awtismlover/photon-line-follower/README.md

<h1 align="center"> Photon1.0: Turbo Line Follower Robot</h1>

<div align="center">

   

<i>Loved the project? Please consider giving a Star ⭐️</i>

</div>

## ⭐️For now work in progres⭐️

> ### **Photon will be fast and light line follower robot with track optimalization.**

## Custom ESC

> ### **For the drive system Photon will use BLDC motors which will be driven by ESCs based on Escape32**

<div align="center">
  
</div>

## Hardware

- uC - STM32G474RET6
- drivers - Custom ESCs
- sensor - 12x KTIR0711S
- battery - 300mAh 3s LiPo
- wheels - Kyosho Mini Z
- motors - 1404 BLDC
- Bluetooth - HC-04

## Credits
> Photon uses custom BLDC based on neoxic's ESCape32 project
> https://github.com/neoxic/ESCape32
