awtismlover/photon-line-follower/photon_bldc/hardware/pcb/G071_ESC_rev2/ESC_PCB/Fortior Tech FD6288Q driver library/FD6288Q.step

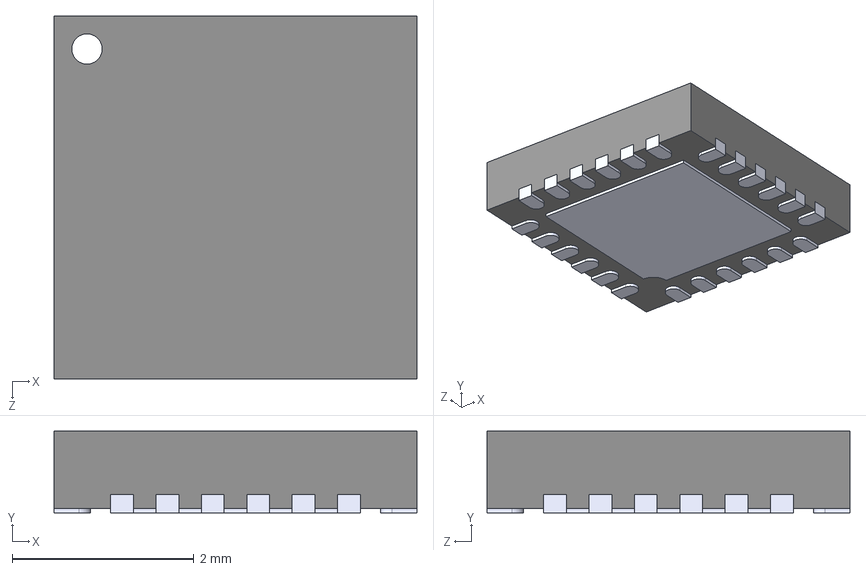
[picture p1: CAD file, 2025-04-08]
photon_bldc/hardware/pcb/G071_ESC_rev2/ESC_PCB/Fortior Tech FD6288Q driver library/FD6288Q.step
4.00 x 0.9 x 4.00 mm
