awtismlover/photon-line-follower/photon_bldc/hardware/pcb/G071_ESC_rev2/ESC_PCB/MOSFET 3D Model/User Library-TDSON-8-1.STEP

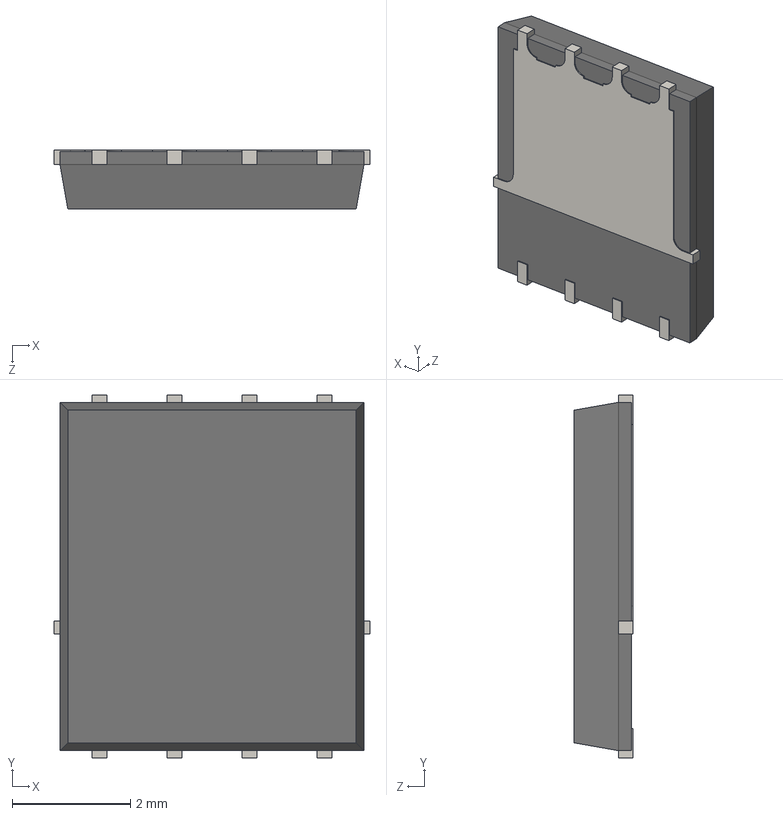
[picture p2: CAD file, 2025-04-15]
photon_bldc/hardware/pcb/G071_ESC_rev2/ESC_PCB/MOSFET 3D Model/User Library-TDSON-8-1.STEP
5.35 x 6.15 x 1.00 mm
