awtismlover/photon-line-follower/photon_bldc/hardware/pcb/G071_ESC_rev2/ESC_PCB/MOSFET_lib/PDFN3333 (DFN8 3.3x3.3).STEP

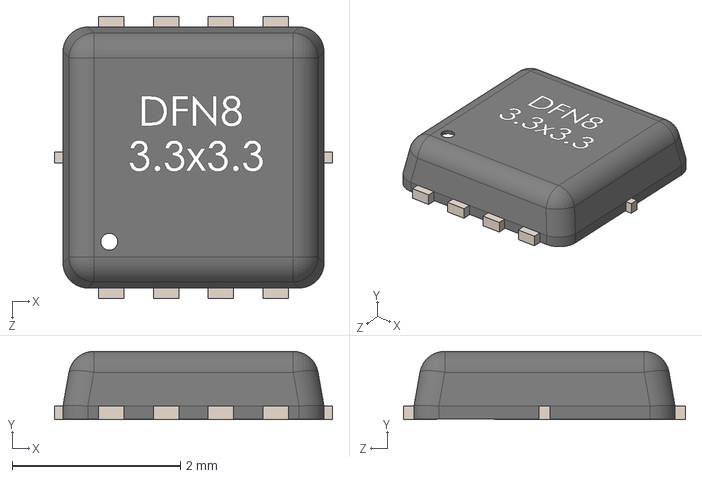
[picture p3: CAD file, 2025-07-21]
photon_bldc/hardware/pcb/G071_ESC_rev2/ESC_PCB/MOSFET_lib/PDFN3333 (DFN8 3.3x3.3).STEP
3.30 x 0.81 x 3.35 mm
