awtismlover/photon-line-follower/photon_bldc/hardware/pcb/G071_ESC_rev2/ESC_PCB/TPHR8504PL_L1Q.step

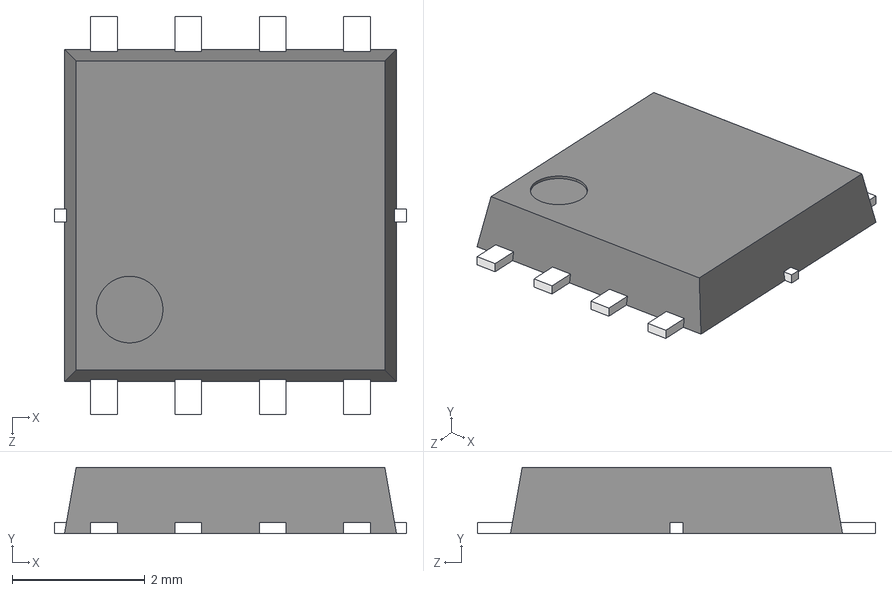
[picture p4: CAD file, 2025-07-26]
photon_bldc/hardware/pcb/G071_ESC_rev2/ESC_PCB/TPHR8504PL_L1Q.step
5.30 x 1.00 x 6.00 mm
