awtismlover/photon-line-follower/photon_bldc/hardware/pcb/IMU_ICM42688/ICM42688/ICM-42688-P/ICM-42688-P.step

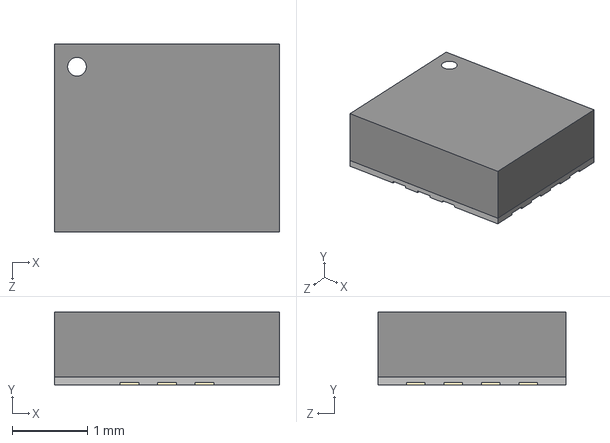
[picture p5: CAD file, 2025-04-16]
photon_bldc/hardware/pcb/IMU_ICM42688/ICM42688/ICM-42688-P/ICM-42688-P.step
3.00 x 0.97 x 2.50 mm
