awtismlover/photon-line-follower/photon_bldc/hardware/pcb/one_sided_main_board/HC-04 v2.step

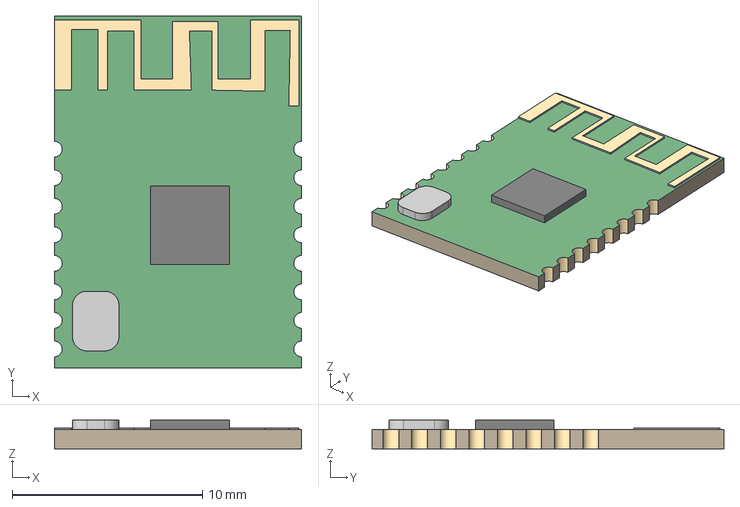
[picture p6: CAD file, 2025-03-23]
photon_bldc/hardware/pcb/one_sided_main_board/HC-04 v2.step
13.0 x 18.5 x 1.50 mm
