awtismlover/photon-line-follower/photon_bldc/hardware/pcb/G071_ESC_rev2/ESC_PCB/UFQFPN28-4x4-05.step

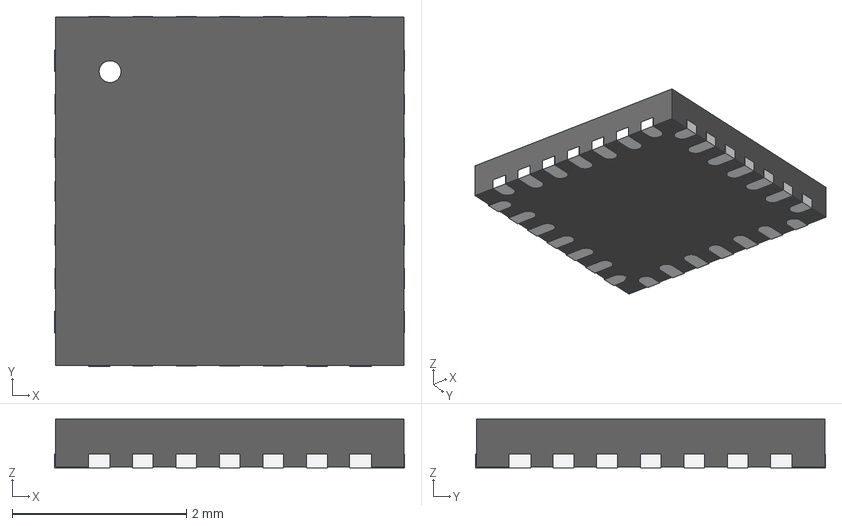
[picture p8: CAD file, 2025-04-20]
photon_bldc/hardware/pcb/G071_ESC_rev2/ESC_PCB/UFQFPN28-4x4-05.step
4.03 x 4.02 x 0.56 mm
Pin001
CPin001
CPin002
Pin002
Pin003
Pin004
Pin005
CPin003
CPin004
CPin005
CPin006
CPin007
CPin008
