awtismlover/photon-line-follower/photon_bldc/hardware/pcb/one_sided_main_board/JST_SH_3D_models/SM05B-SRSS-TB.STEP

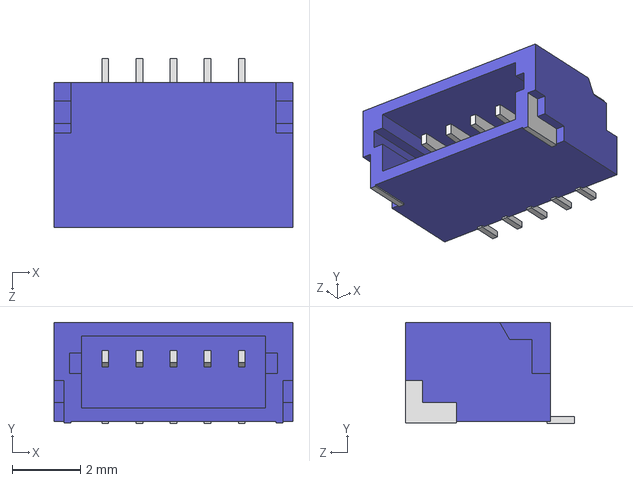
[picture p9: CAD file, 2025-05-06]
photon_bldc/hardware/pcb/one_sided_main_board/JST_SH_3D_models/SM05B-SRSS-TB.STEP
7.00 x 2.96 x 4.95 mm
