awtismlover/photon-line-follower/photon_bldc/hardware/pcb/one_sided_main_board/JST_SH_3D_models/SM02B-SRSS-TB.STEP

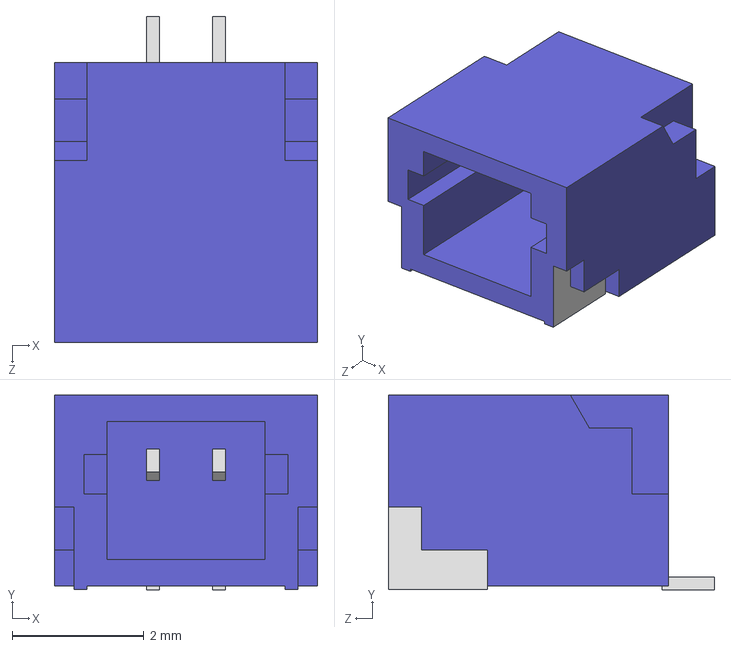
[picture p10: CAD file, 2025-05-06]
photon_bldc/hardware/pcb/one_sided_main_board/JST_SH_3D_models/SM02B-SRSS-TB.STEP
4.00 x 2.96 x 4.95 mm
