awtismlover/photon-line-follower/photon_bldc/hardware/pcb/one_sided_main_board/JST_SH_3D_models/SM07B-SRSS-TB v1.step

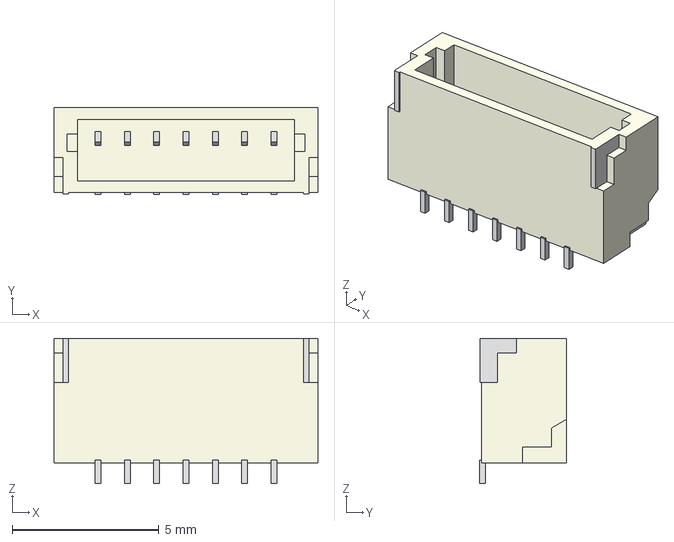
[picture p12: CAD file, 2025-05-06]
photon_bldc/hardware/pcb/one_sided_main_board/JST_SH_3D_models/SM07B-SRSS-TB v1.step
9.00 x 2.96 x 4.95 mm
