awtismlover/photon-line-follower/(list of files, cad)

Other CAD files:
photon_bldc/hardware/pcb/one_sided_main_board/JST_SH_3D_models/SM04B-SRSS-TB v1.step
photon_bldc/hardware/pcb/one_sided_main_board/JST_SH_3D_models/SM05B-SRSS-TB v1.step
photon_bldc/hardware/pcb/one_sided_main_board/JST_SH_3D_models/SM06B-SRSS-TB.STEP
photon_bldc/hardware/pcb/one_sided_main_board/JST_SH_3D_models/SM02B-SRSS-TB v1.step
photon_bldc/hardware/pcb/one_sided_main_board/JST_SH_3D_models/SM07B-SRSS-TB.STEP
