awtismlover/photon-line-follower/(list of files, drawings)

Other design files:
photon_bldc/hardware/pcb/prototype(v0)/hc-04/PCB_NEW_PCB_2024-11-19.json
