awtismlover/photon-line-follower/photon_bldc/hardware/pcb/Encoder_KTH_7812/KTH7812/KTH7812.kicad_pcb

## KiCad design photon_bldc/hardware/pcb/Encoder_KTH_7812/KTH7812/KTH7812.kicad_pcb (2025-09-22)

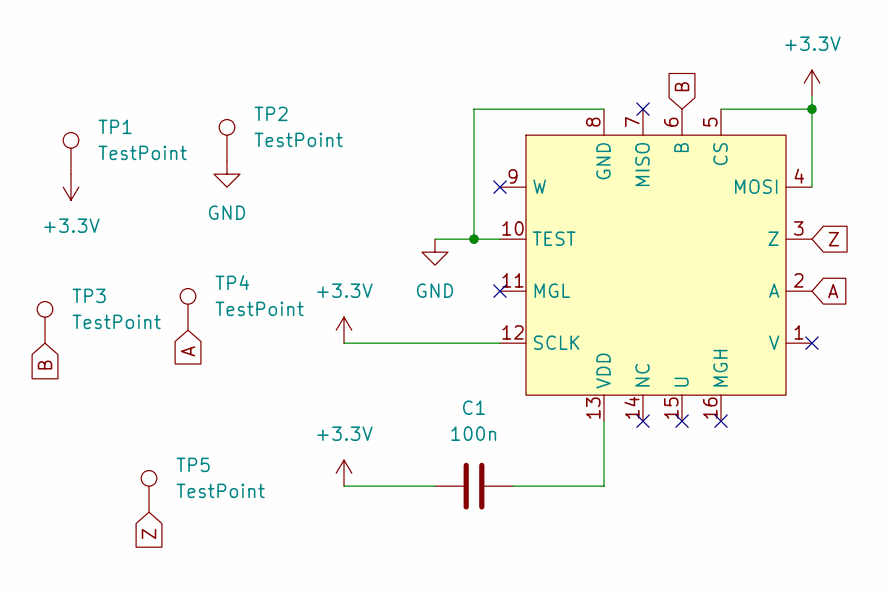
[picture p13: schematic KTH7812.kicad_sch]

Parts:
C1: 100n; C_0402_1005Metric
TP1, TP2, TP3, TP4, TP5: TestPoint; TestPoint_Pad_1.0x1.0mm
U1: KTH7812

Connections:
+3.3V: C1.1, TP1.1, U1.4 (MOSI), U1.5 (CS), U1.12 (SCLK)
A: TP4.1, U1.2 (A)
B: TP3.1, U1.6 (B)
GND: TP2.1, U1.8 (GND), U1.10 (TEST)
unnamed: C1.2, U1.13 (VDD)
Z: TP5.1, U1.3 (Z)

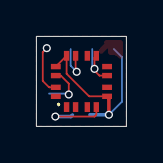
[picture p14: board KTH7812.kicad_pcb from above]

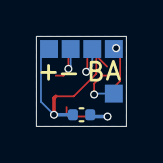
[picture p15: board KTH7812.kicad_pcb from below]

Board: 2 copper layers, 5.0 x 5.0 mm, 7 parts (6 on the bottom side), 6 nets.
