awtismlover/photon-line-follower/photon_bldc/hardware/pcb/IMU_ICM42688/ICM42688/ICM42688.kicad_pcb

## KiCad design photon_bldc/hardware/pcb/IMU_ICM42688/ICM42688/ICM42688.kicad_pcb (2025-09-16)

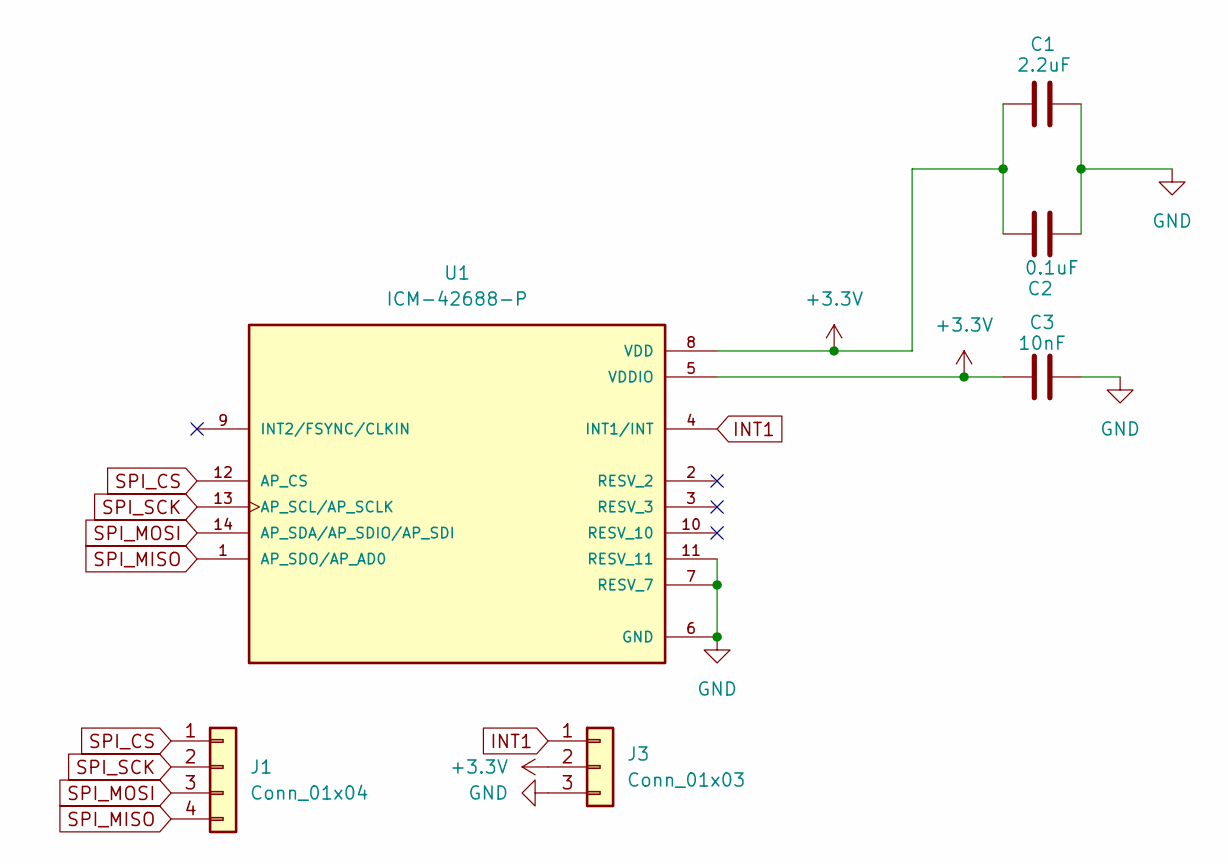
[picture p16: schematic ICM42688.kicad_sch]

Parts:
C1: 2.2uF; C_0402_1005Metric_Pad0.74x0.62mm_HandSolder
C2: 0.1uF; C_0402_1005Metric_Pad0.74x0.62mm_HandSolder
C3: 10nF; C_0402_1005Metric_Pad0.74x0.62mm_HandSolder
J1: Conn_01x04; 4_cable_pad
J3: Conn_01x03; 3_cable_pad
U1: ICM-42688-P; PQFN50P300X250X97-14N; PARTREV 1.2

Connections:
+3.3V: C1.2, C2.1, C3.1, J3.2, U1.5 (VDDIO), U1.8 (VDD)
GND: C1.1, C2.2, C3.2, J3.3, U1.6 (GND), U1.7 (RESV_7), U1.11 (RESV_11)
INT1: J3.1, U1.4 (INT1/INT)
SPI_CS: J1.1, U1.12 (AP_CS)
SPI_MISO: J1.4, U1.1 (AP_SDO/AP_AD0)
SPI_MOSI: J1.3, U1.14 (AP_SDA/AP_SDIO/AP_SDI)
SPI_SCK: J1.2, U1.13 (AP_SCL/AP_SCLK)

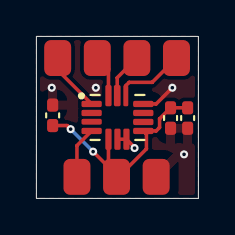
[picture p17: board ICM42688.kicad_pcb from above]

Board: 2 copper layers, 9.0 x 9.0 mm, 6 parts (0 on the bottom side), 7 nets.
