awtismlover/photon-line-follower/photon_bldc/hardware/pcb/G071_ESC_rev2/ESC_PCB/ESC_PCB.kicad_pcb

## KiCad design photon_bldc/hardware/pcb/G071_ESC_rev2/ESC_PCB/ESC_PCB.kicad_pcb (2025-07-27)

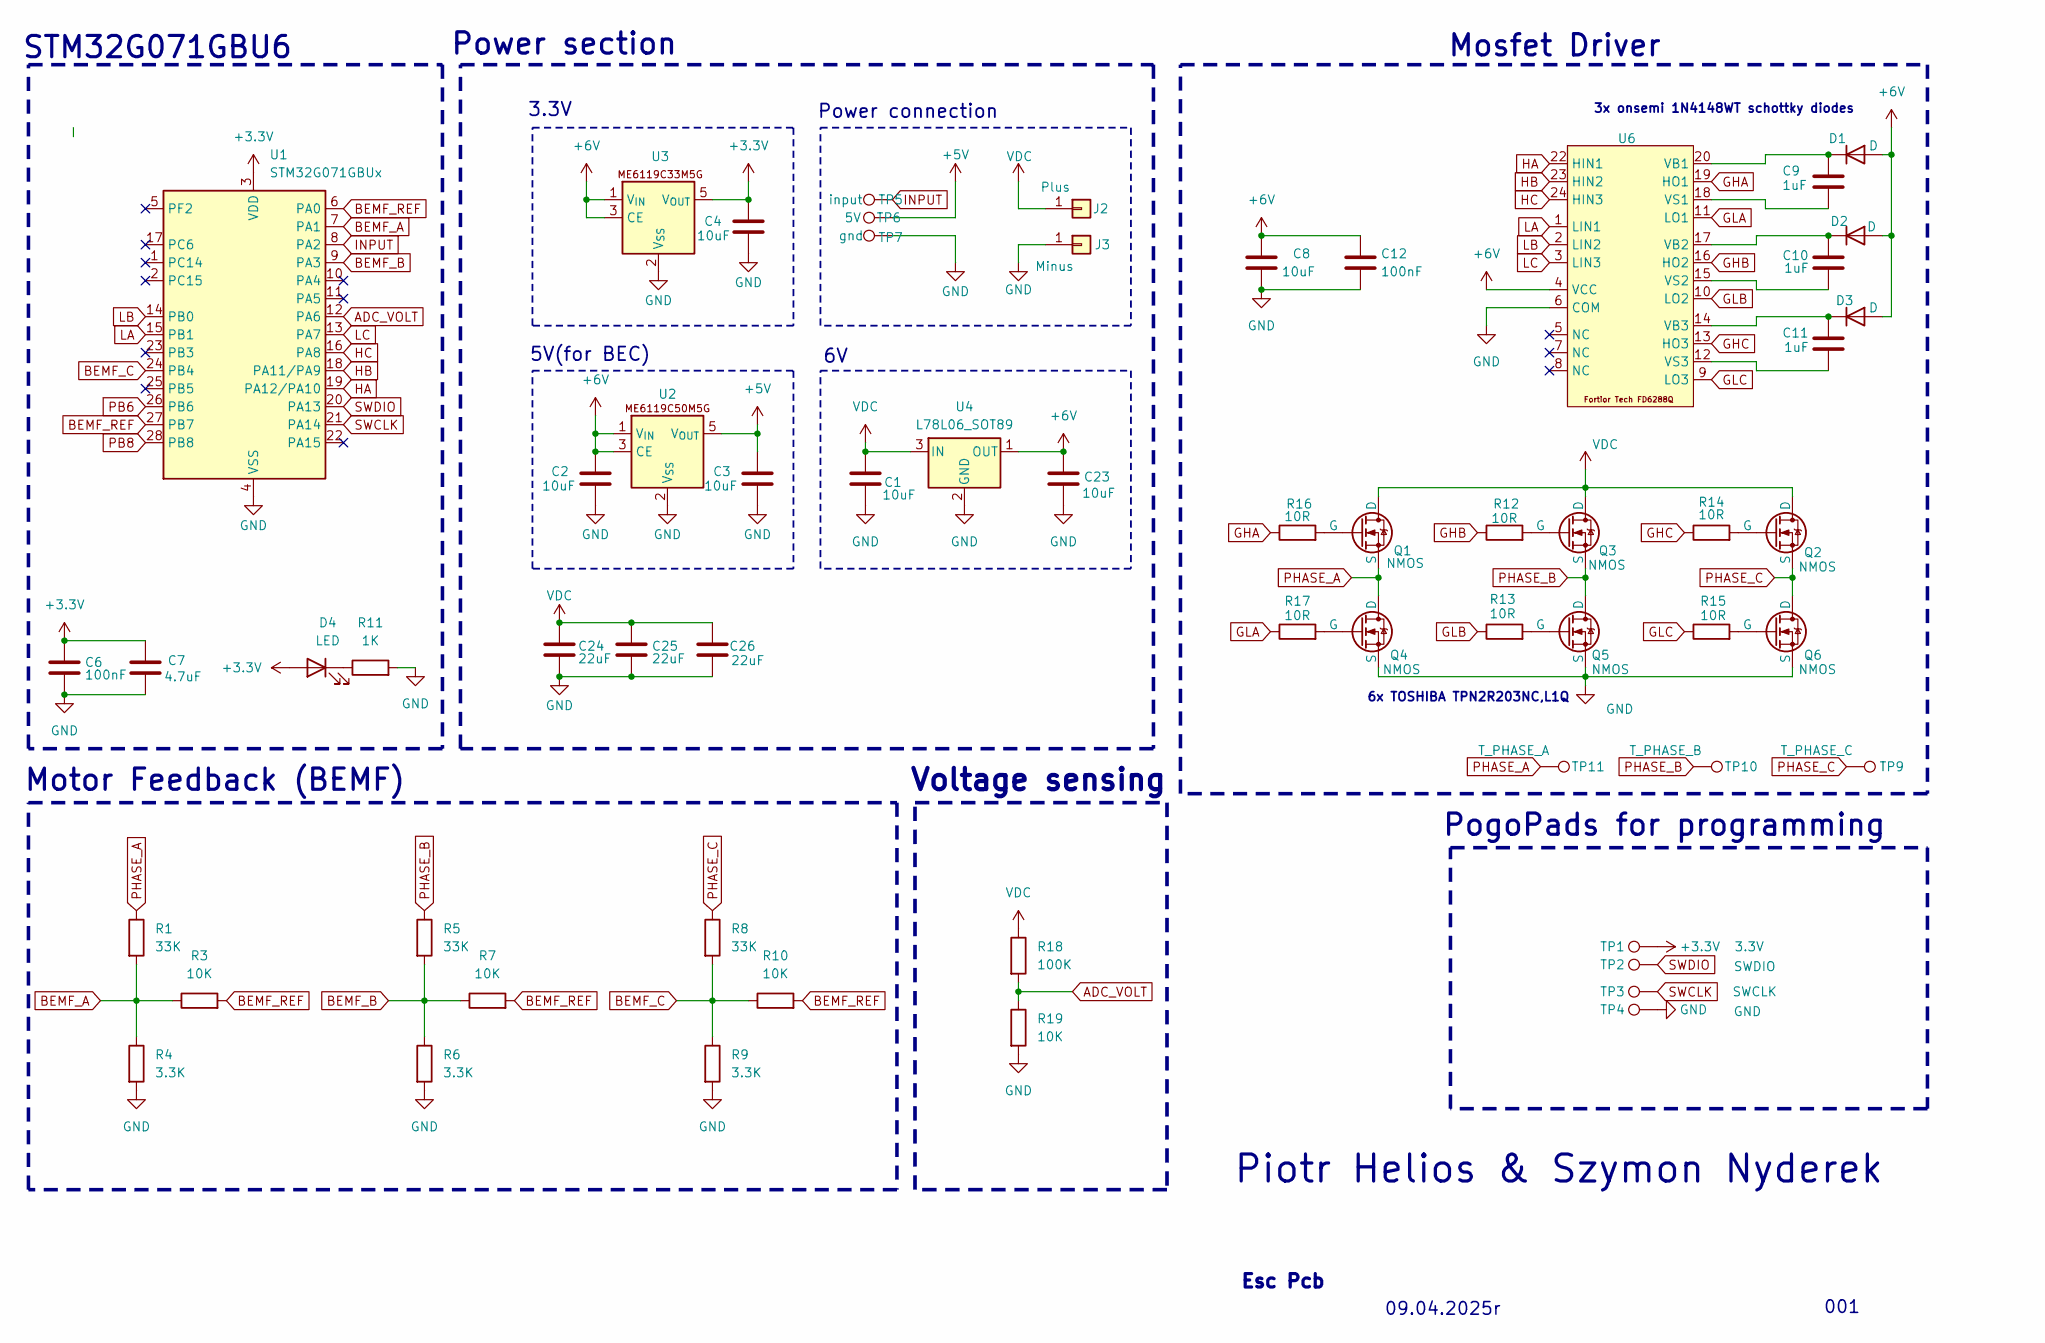
[picture p18: schematic ESC_PCB.kicad_sch]

Parts:
C1, C2, C3, C4: 10uF; C_0402_1005Metric_Pad0.74x0.62mm_HandSolder
C6, C12: 100nF; C_0402_1005Metric_Pad0.74x0.62mm_HandSolder
C7: 4.7uF; C_0402_1005Metric_Pad0.74x0.62mm_HandSolder
C8, C23: 10uF; C_0603_1608Metric_Pad1.08x0.95mm_HandSolder
C9, C10, C11: 1uF; C_0402_1005Metric_Pad0.74x0.62mm_HandSolder
C24, C25, C26: 22uF; C_0805_2012Metric_Pad1.18x1.45mm_HandSolder
D1, D2, D3: D; D_SOD-523
D4: LED; LED_0603_1608Metric_Pad1.05x0.95mm_HandSolder
J2: Plus; PowerPad
J3: Minus; PowerPad
Q1, Q2, Q3, Q4, Q5, Q6: NMOS; TRANS_TPHR8504PL_L1Q
R1, R5, R8: 33K; R_0402_1005Metric_Pad0.72x0.64mm_HandSolder
R3, R7, R10, R19: 10K; R_0402_1005Metric_Pad0.72x0.64mm_HandSolder
R4, R6, R9: 3.3K; R_0402_1005Metric_Pad0.72x0.64mm_HandSolder
R11: 1K; R_0402_1005Metric_Pad0.72x0.64mm_HandSolder
R12, R13, R14, R15, R16, R17: 10R; R_0402_1005Metric_Pad0.72x0.64mm_HandSolder
R18: 100K; R_0402_1005Metric_Pad0.72x0.64mm_HandSolder
TP1: 3.3V; TestPoint_Pad_D1.0mm
TP2: SWDIO; TestPoint_Pad_D1.0mm
TP3: SWCLK; TestPoint_Pad_D1.0mm
TP4: GND; TestPoint_Pad_D1.0mm
TP5: input; SolderWirePad_1x01_SMD_1x2mm
TP6: 5V; SolderWirePad_1x01_SMD_1x2mm
TP7: gnd; SolderWirePad_1x01_SMD_1x2mm
TP9: T_PHASE_C; PhasePad
TP10: T_PHASE_B; PhasePad
TP11: T_PHASE_A; PhasePad
U1: STM32G071GBUx; QFN-28_4x4mm_P0.5mm
U2, U3: SOT-23-5
U4: L78L06_SOT89; SOT-89-3
U6: QFN50P400X400X90-25N

Connections:
+3.3V: C4.1, C6.1, C7.1, D4.2 (A), TP1.1, U1.3 (VDD), U3.5 (V_{OUT})
+5V: C3.1, TP6.1, U2.5 (V_{OUT})
+6V: C2.1, C8.1, C12.1, C23.1, D1.2 (A), D2.2 (A), D3.2 (A), U2.1 (V_{IN}), U2.3 (CE), U3.1 (V_{IN}), U3.3 (CE), U4.1 (OUT), U6.4 (VCC)
ADC_VOLT: R18.2, R19.1, U1.12 (PA6)
BEMF_A: R1.2, R3.1, R4.1, U1.7 (PA1)
BEMF_B: R5.2, R6.1, R7.1, U1.9 (PA3)
BEMF_C: R8.2, R9.1, R10.1, U1.24 (PB4)
BEMF_REF: R3.2, R7.2, R10.2, U1.6 (PA0), U1.27 (PB7)
GHA: R16.1, U6.19 (HO1)
GHB: R12.1, U6.16 (HO2)
GHC: R14.1, U6.13 (HO3)
GLA: R17.1, U6.11 (LO1)
GLB: R13.1, U6.10 (LO2)
GLC: R15.1, U6.9 (LO3)
GND: C1.2, C2.2, C3.2, C4.2, C6.2, C7.2, C8.2, C12.2, C23.2, C24.2, C25.2, C26.2, J3.1, Q4.3 (S), Q5.3 (S), Q6.3 (S), R4.2, R6.2, R9.2, R11.2, R19.2, TP4.1, TP7.1, U1.4 (VSS), U2.2 (V_{SS}), U3.2 (V_{SS}), U4.2 (GND), U6.6 (COM); also elsewhere on the board
HA: U1.19 (PA12/PA10), U6.22 (HIN1)
HB: U1.18 (PA11/PA9), U6.23 (HIN2)
HC: U1.16 (PA8), U6.24 (HIN3)
INPUT: TP5.1, U1.8 (PA2)
LA: U1.15 (PB1), U6.1 (LIN1)
LB: U1.14 (PB0), U6.2 (LIN2)
LC: U1.13 (PA7), U6.3 (LIN3)
unnamed: C9.1, D1.1 (K), U6.20 (VB1)
unnamed: C10.1, D2.1 (K), U6.17 (VB2)
unnamed: C11.1, D3.1 (K), U6.14 (VB3)
unnamed: D4.1 (K), R11.1
unnamed: Q1.2 (G), R16.2
unnamed: Q2.2 (G), R14.2
unnamed: Q3.2 (G), R12.2
unnamed: Q4.2 (G), R17.2
unnamed: Q5.2 (G), R13.2
unnamed: Q6.2 (G), R15.2
unnamed: C9.2, U6.18 (VS1)
unnamed: C10.2, U6.15 (VS2)
unnamed: C11.2, U6.12 (VS3)
PB6: U1.26 (PB6)
PB8: U1.28 (PB8)
PHASE_A: Q1.3 (S), Q4.1 (D), R1.1, TP11.1
PHASE_B: Q3.3 (S), Q5.1 (D), R5.1, TP10.1
PHASE_C: Q2.3 (S), Q6.1 (D), R8.1, TP9.1
SWCLK: TP3.1, U1.21 (PA14)
SWDIO: TP2.1, U1.20 (PA13)
VDC: C1.1, C24.1, C25.1, C26.1, J2.1, Q1.1 (D), Q2.1 (D), Q3.1 (D), R18.1, U4.3 (IN); also elsewhere on the board

Notes on the sheet:
Power section
001
3x onsemi 1N4148WT schottky diodes
3.3V
Esc Pcb
5V(for BEC)
Piotr Helios & Szymon Nyderek
Voltage sensing
Motor Feedback (BEMF)
Mosfet Driver
Power connection
STM32G071GBU6
PogoPads for programming
6x TOSHIBA TPN2R203NC,L1Q
09.04.2025r

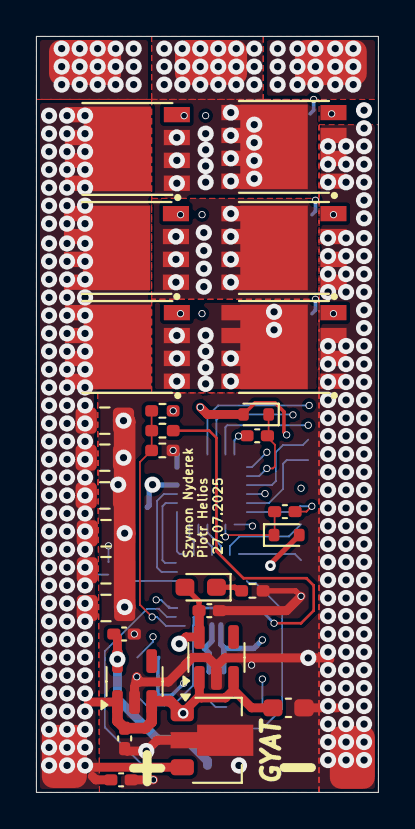
[picture p19: board ESC_PCB.kicad_pcb from above]

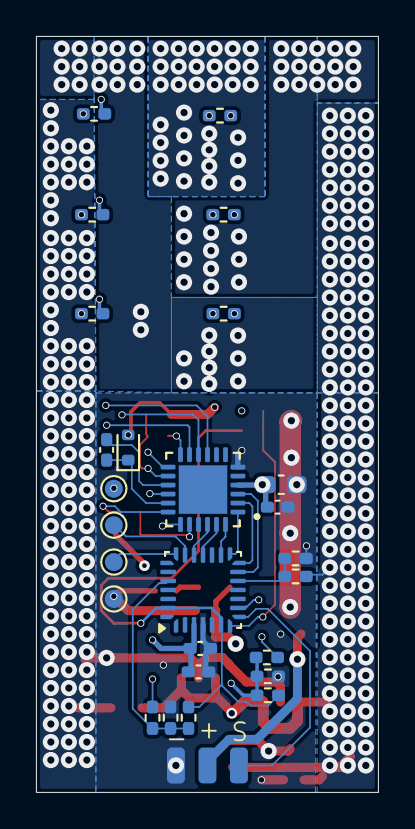
[picture p20: board ESC_PCB.kicad_pcb from below]

Board: 6 copper layers, 19.0 x 42.0 mm, 63 parts (29 on the bottom side), 41 nets.

Other parts of the board:
C24#2, C25#2, C26#2: 22uF; C_0805_2012Metric_Pad1.18x1.45mm_HandSolder

Their connections:
GND: C24#2.2, C25#2.2, C26#2.2; also elsewhere on the board
VDC: C24#2.1, C25#2.1, C26#2.1; also elsewhere on the board
