awtismlover/photon-line-follower/photon_bldc/hardware/pcb/Sensor_Analog/AnalogSensorPCB/AnalogSensorPCB.kicad_pcb

## KiCad design photon_bldc/hardware/pcb/Sensor_Analog/AnalogSensorPCB/AnalogSensorPCB.kicad_pcb (2025-05-13)

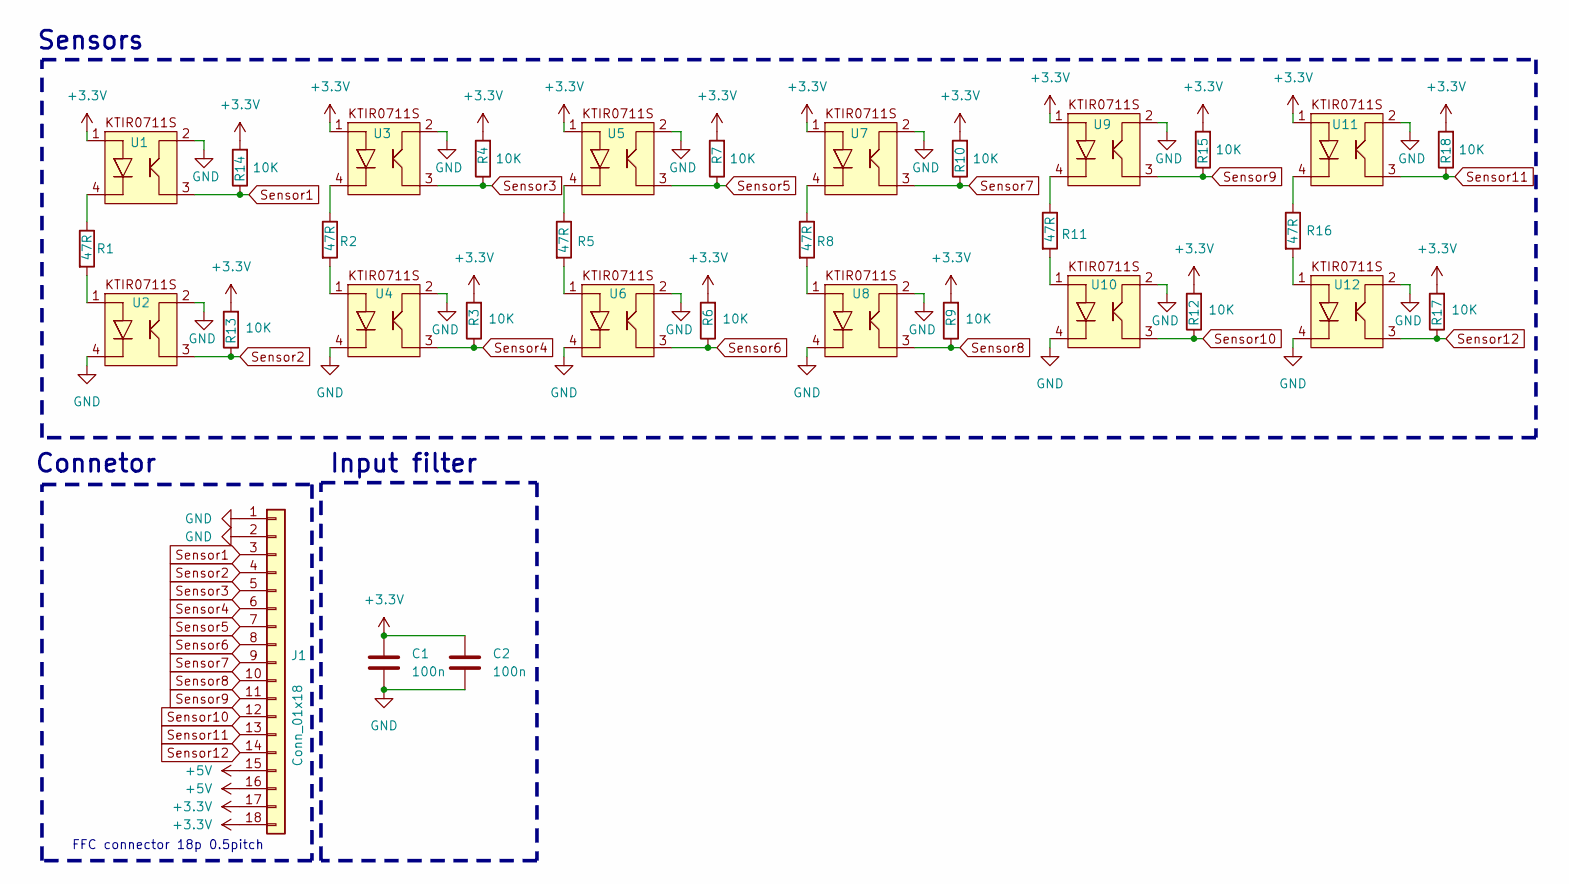
[picture p21: schematic AnalogSensorPCB.kicad_sch]

Parts:
C1, C2: 100n; C_0402_1005Metric_Pad0.74x0.62mm_HandSolder
J1: Conn_01x18; Hirose_FH12-18S-0.5SH_1x18-1MP_P0.50mm_Horizontal
R1, R2, R5, R8, R11, R16: 47R; R_0603_1608Metric_Pad0.98x0.95mm_HandSolder
R3, R4, R6, R7, R9, R10, R12, R13, R14, R15, R17, R18: 10K; R_0402_1005Metric_Pad0.72x0.64mm_HandSolder
U1, U2, U3, U4, U5, U6, U7, U8, U9, U10, U11, U12: KTIR0711S

Connections:
+3.3V: C1.1, C2.1, J1.17, J1.18, R3.2, R4.2, R6.2, R7.2, R9.2, R10.2, R12.2, R13.2, R14.2, R15.2, R17.2, R18.2, U1.1, U3.1, U5.1, U7.1, U9.1, U11.1
+5V: J1.15, J1.16
GND: C1.2, C2.2, J1.1, J1.2, J1.MP, U1.2, U2.2, U2.4, U3.2, U4.2, U4.4, U5.2, U6.2, U6.4, U7.2, U8.2, U8.4, U9.2, U10.2, U10.4, U11.2, U12.2, U12.4
unnamed: R1.1, U1.4
unnamed: R1.2, U2.1
unnamed: R2.1, U3.4
unnamed: R2.2, U4.1
unnamed: R5.1, U5.4
unnamed: R5.2, U6.1
unnamed: R8.1, U7.4
unnamed: R8.2, U8.1
unnamed: R11.1, U9.4
unnamed: R11.2, U10.1
unnamed: R16.1, U11.4
unnamed: R16.2, U12.1
Sensor1: J1.3, R14.1, U1.3
Sensor2: J1.4, R13.1, U2.3
Sensor3: J1.5, R4.1, U3.3
Sensor4: J1.6, R3.1, U4.3
Sensor5: J1.7, R7.1, U5.3
Sensor6: J1.8, R6.1, U6.3
Sensor7: J1.9, R10.1, U7.3
Sensor8: J1.10, R9.1, U8.3
Sensor9: J1.11, R15.1, U9.3
Sensor10: J1.12, R12.1, U10.3
Sensor11: J1.13, R18.1, U11.3
Sensor12: J1.14, R17.1, U12.3

Notes on the sheet:
FFC connector 18p 0.5pitch
Input filter
Connetor
Sensors

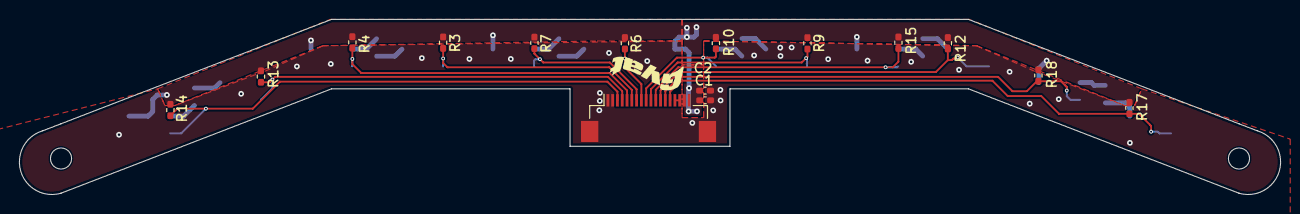
[picture p22: board AnalogSensorPCB.kicad_pcb from above]

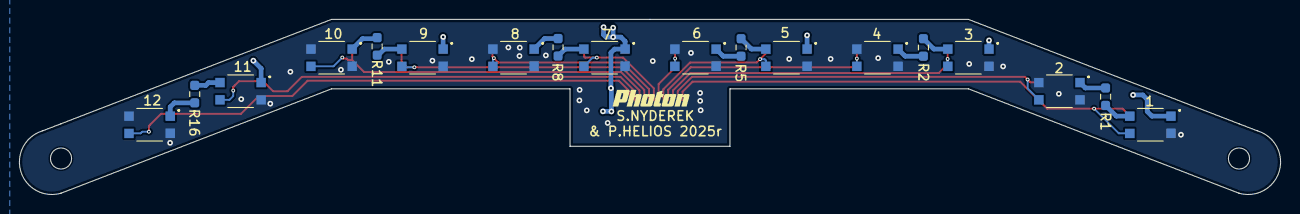
[picture p23: board AnalogSensorPCB.kicad_pcb from below]

Board: 2 copper layers, 131.7 x 18.3 mm, 33 parts (18 on the bottom side), 27 nets.
