awtismlover/photon-line-follower/photon_bldc/hardware/pcb/one_sided_main_board/main_board.kicad_pcb

## KiCad design photon_bldc/hardware/pcb/one_sided_main_board/main_board.kicad_pcb (2025-05-12)

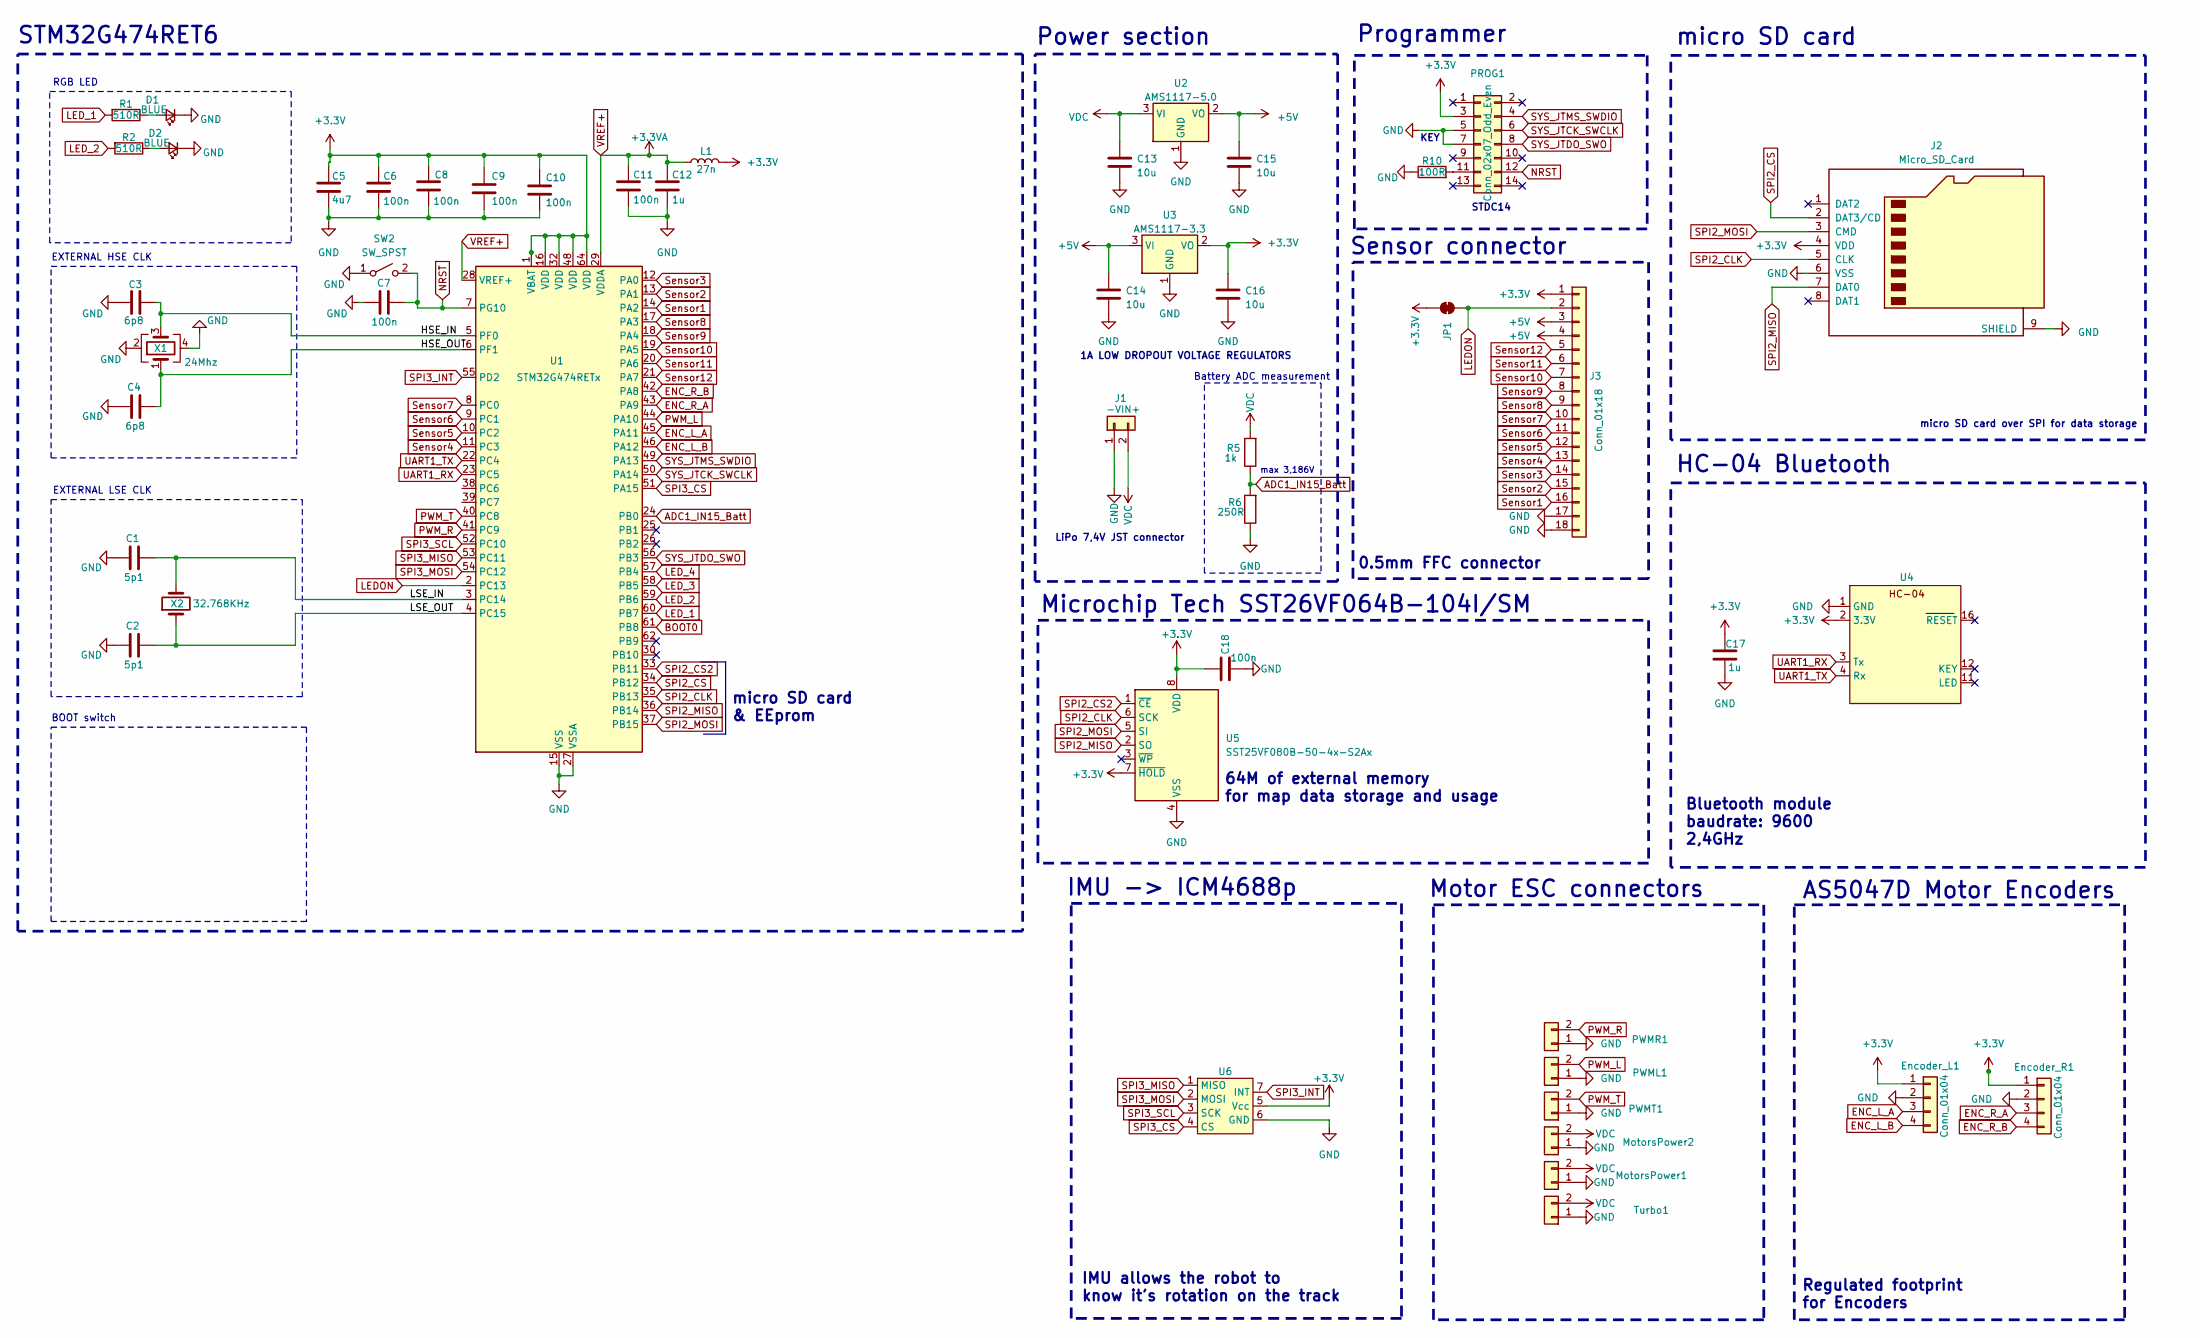
[picture p24: schematic main_board.kicad_sch]

Parts:
C1, C2: 5p1; C_0603_1608Metric
C3, C4: 6p8; C_0603_1608Metric
C5: 4u7; C_0603_1608Metric
C6, C7, C8, C9, C10, C11, C18: 100n; C_0603_1608Metric
C12, C17: 1u; C_0603_1608Metric
C13, C14, C15, C16: 10u; C_0603_1608Metric
D1, D2: BLUE; LED_0603_1608Metric; LCSC Part # C72041
Encoder_L1: Conn_01x04; JST_SH_SM04B-SRSS-TB_1x04-1MP_P1.00mm_Horizontal
Encoder_R1: Conn_01x04; JST_SH_SM04B-SRSS-TB_1x04-1MP_P1.00mm_Horizontal
J1: -VIN+; AMASS_XT30U-F_1x02_P5.0mm_Vertical
J2: Micro_SD_Card; SdCard
J3: Conn_01x18; Hirose_FH12-18S-0.5SH_1x18-1MP_P0.50mm_Horizontal
JP1: SolderJumper_2_Bridged; SolderJumper-2_P1.3mm_Bridged2Bar_RoundedPad1.0x1.5mm
L1: 27n; L_0603_1608Metric
MotorsPower1, MotorsPower2: Conn_01x02; PowerConn
PROG1: Conn_02x07_Odd_Even; PinHeader_2x07_P1.27mm_Vertical_SMD
PWML1: Conn_01x02; JST_SH_SM02B-SRSS-TB_1x02-1MP_P1.00mm_Horizontal
PWMR1: Conn_01x02; JST_SH_SM02B-SRSS-TB_1x02-1MP_P1.00mm_Horizontal
PWMT1: Conn_01x02; JST_SH_SM02B-SRSS-TB_1x02-1MP_P1.00mm_Horizontal
R1, R2: 510R; R_0603_1608Metric
R5: 1k; R_0603_1608Metric
R6: 250R; R_0603_1608Metric
R10: 100R; R_0603_1608Metric
SW2: SW_SPST; SW_SPST_CK_RS282G05A3
Turbo1: Conn_01x02; PowerConn
U1: STM32G474RETx; LQFP-64_10x10mm_P0.5mm
U2: AMS1117-5.0; SOT-223-3_TabPin2
U3: AMS1117-3.3; SOT-223-3_TabPin2
U4: HC-04
U5: SST25VF080B-50-4x-S2Ax; SOIC-8_5.275x5.275mm_P1.27mm
U6: ICM_MOUNT
X1: 24Mhz; Crystal_SMD_2016-4Pin_2.0x1.6mm
X2: 32.768KHz; Crystal_SMD_3215-2Pin_3.2x1.5mm

Connections:
+3.3V: C5.1, C6.1, C8.1, C9.1, C10.1, C16.1, C17.1, C18.1, Encoder_L1.1, Encoder_R1.1, J2.4 (VDD), J3.1, JP1.2 (B), L1.2, PROG1.3, U1.1 (VBAT), U1.16 (VDD), U1.32 (VDD), U1.48 (VDD), U1.64 (VDD), U3.2 (VO), U4.2 (3.3V), U5.7 (~HOLD), U5.8 (VDD), U6.5 (Vcc); also elsewhere on the board
+5V: C14.1, C15.1, J3.3, J3.4, U2.2 (VO), U3.3 (VI)
/HSE_IN: C3.2, U1.5 (PF0), X1.3
/HSE_OUT: C4.2, U1.6 (PF1), X1.1
/LSE_IN: C1.2, U1.3 (PC14), X2.2
/LSE_OUT: C2.2, U1.4 (PC15), X2.1
ADC1_IN15_Batt: R5.1, R6.2, U1.24 (PB0)
BOOT0: U1.61 (PB8)
ENC_L_A: Encoder_L1.3, U1.45 (PA11)
ENC_L_B: Encoder_L1.4, U1.46 (PA12)
ENC_R_A: Encoder_R1.3, U1.43 (PA9)
ENC_R_B: Encoder_R1.4, U1.42 (PA8)
GND: C1.1, C2.1, C3.1, C4.1, C5.2, C6.2, C7.1, C8.2, C9.2, C10.2, C11.2, C12.2, C13.2, C14.2, C15.2, C16.2, C17.2, C18.2, D1.1 (K), D2.1 (K), Encoder_L1.2, Encoder_R1.2, J1.1, J2.6 (VSS), J2.9 (SHIELD), J2.SH, J3.17, J3.18, J3.MP, MotorsPower1.1, MotorsPower2.1, PROG1.5, PROG1.7, PWML1.1, PWMR1.1, PWMT1.1, R6.1, R10.1, SW2.1 (A), Turbo1.1, U1.15 (VSS), U1.27 (VSSA), U1.31 (VSS), U1.47 (VSS), U1.63 (VSS), U2.1 (GND), U3.1 (GND), U4.1 (GND), U5.4 (VSS), U6.6 (GND), X1.2, X1.4
LEDON: J3.2, JP1.1 (A), U1.2 (PC13); also elsewhere on the board
LED_1: R1.2, U1.60 (PB7)
LED_2: R2.2, U1.59 (PB6)
LED_3: U1.58 (PB5)
LED_4: U1.57 (PB4)
NRST: C7.2, PROG1.12, SW2.2 (B), U1.7 (PG10)
unnamed: D1.2 (A), R1.1
unnamed: D2.2 (A), R2.1
unnamed: PROG1.11, R10.2
PWM_L: PWML1.2, U1.44 (PA10)
PWM_R: PWMR1.2, U1.41 (PC9)
PWM_T: PWMT1.2, U1.40 (PC8)
SPI2_CLK: J2.5 (CLK), U1.35 (PB13), U5.6 (SCK)
SPI2_CS: J2.2 (DAT3/CD), U1.34 (PB12)
SPI2_CS2: U1.33 (PB11), U5.1 (~CE)
SPI2_MISO: J2.7 (DAT0), U1.36 (PB14), U5.2 (SO)
SPI2_MOSI: J2.3 (CMD), U1.37 (PB15), U5.5 (SI)
SPI3_CS: U1.51 (PA15), U6.4 (CS)
SPI3_INT: U1.55 (PD2), U6.7 (INT)
SPI3_MISO: U1.53 (PC11), U6.1 (MISO)
SPI3_MOSI: U1.54 (PC12), U6.2 (MOSI)
SPI3_SCL: U1.52 (PC10), U6.3 (SCK)
SYS_JTCK_SWCLK: PROG1.6, U1.50 (PA14)
SYS_JTDO_SWO: PROG1.8, U1.56 (PB3)
SYS_JTMS_SWDIO: PROG1.4, U1.49 (PA13)
Sensor1: J3.16, U1.14 (PA2)
Sensor2: J3.15, U1.13 (PA1)
Sensor3: J3.14, U1.12 (PA0)
Sensor4: J3.13, U1.11 (PC3)
Sensor5: J3.12, U1.10 (PC2)
Sensor6: J3.11, U1.9 (PC1)
Sensor7: J3.10, U1.8 (PC0)
Sensor8: J3.9, U1.17 (PA3)
Sensor9: J3.8, U1.18 (PA4)
Sensor10: J3.7, U1.19 (PA5)
Sensor11: J3.6, U1.20 (PA6)
Sensor12: J3.5, U1.21 (PA7)
UART1_RX: U1.23 (PC5), U4.3 (Tx)
UART1_TX: U1.22 (PC4), U4.4 (Rx)
VDC: C13.1, J1.2, MotorsPower1.2, MotorsPower2.2, R5.2, Turbo1.2, U2.3 (VI)
VREF+: C11.1, C12.1, L1.1, U1.28 (VREF+), U1.29 (VDDA)

Notes on the sheet:
Bluetooth module baudrate: 9600 2,4GHz
Regulated footprint for Encoders
RGB LED
HC-04 Bluetooth
EXTERNAL LSE CLK
max 3,186V
EXTERNAL HSE CLK
micro SD card & EEprom
LiPo 7,4V JST connector
IMU allows the robot to know it's rotation on the track
IMU -> ICM4688p
64M of external memory for map data storage and usage
1A LOW DROPOUT VOLTAGE REGULATORS
Motor ESC connectors
micro SD card
Sensor connector
STDC14
AS5047D Motor Encoders
BOOT switch
Microchip Tech SST26VF064B-104I/SM
Power section
KEY
0.5mm FFC connector
Programmer
STM32G474RET6
micro SD card over SPI for data storage
Battery ADC measurement

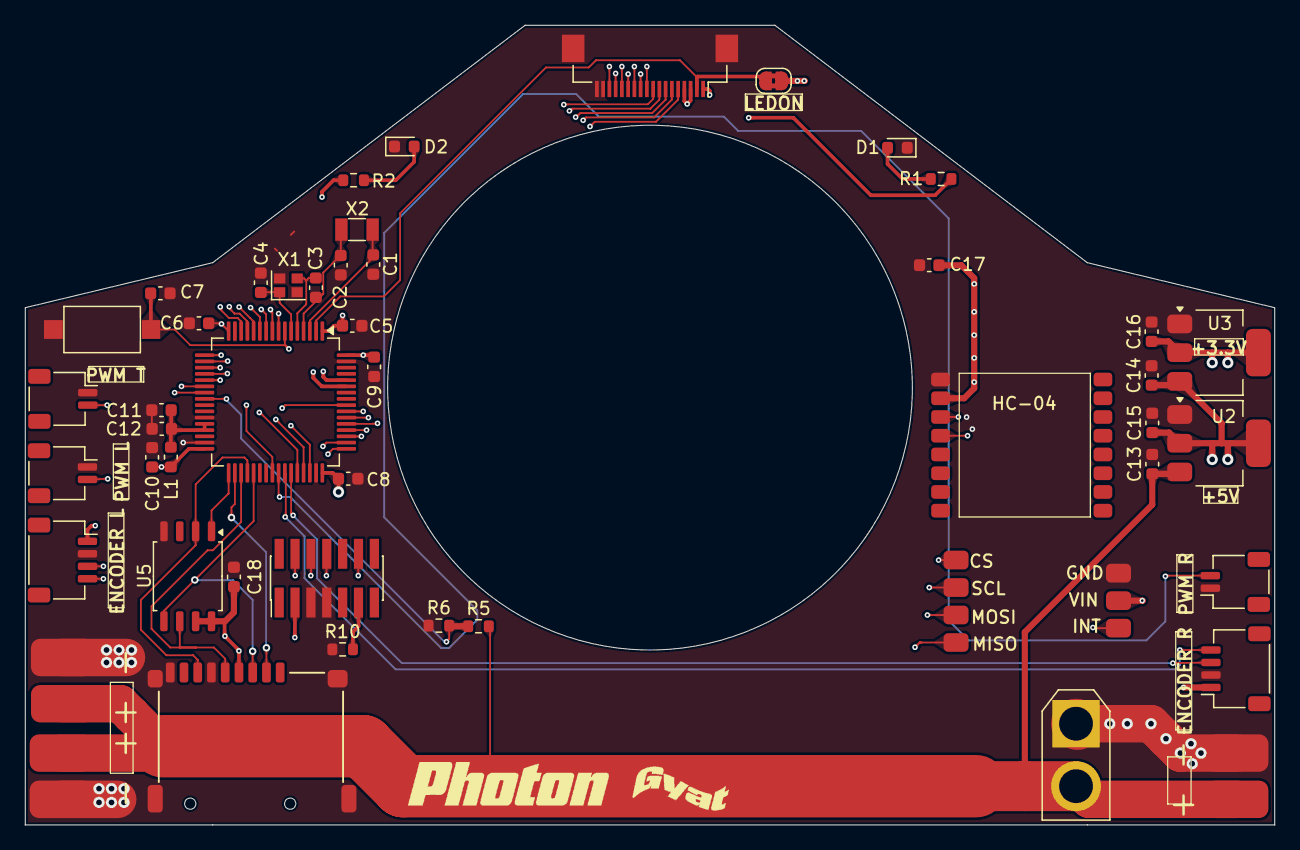
[picture p25: board main_board.kicad_pcb from above]

Board: 4 copper layers, 100.0 x 64.0 mm, 48 parts (0 on the bottom side), 51 nets.

Other parts of the board:
LEDON: SolderJumper_2_Bridged; SolderJumper-2_P1.3mm_Bridged2Bar_RoundedPad1.0x1.5mm

Their connections:
+3.3V: LEDON.2 (B); also elsewhere on the board
LEDON: LEDON.1 (A); also elsewhere on the board
