awtismlover/photon-line-follower/photon_bldc/hardware/pcb/prototype(v0)/photon_bldc.kicad_pcb

## KiCad design photon_bldc/hardware/pcb/prototype(v0)/photon_bldc.kicad_pcb (2025-04-08)

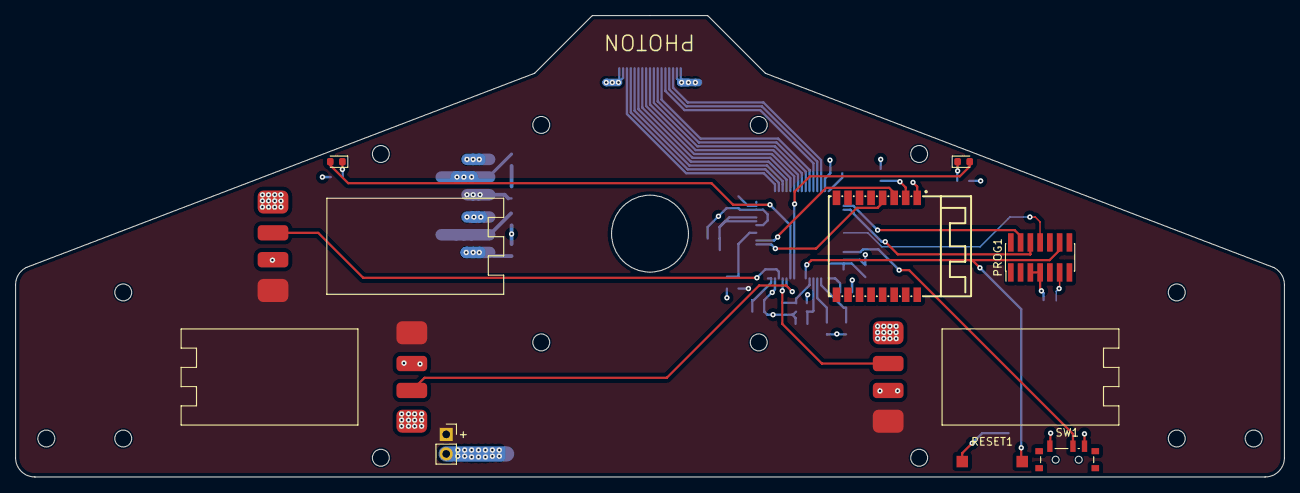
[picture p26: board photon_bldc.kicad_pcb from above]

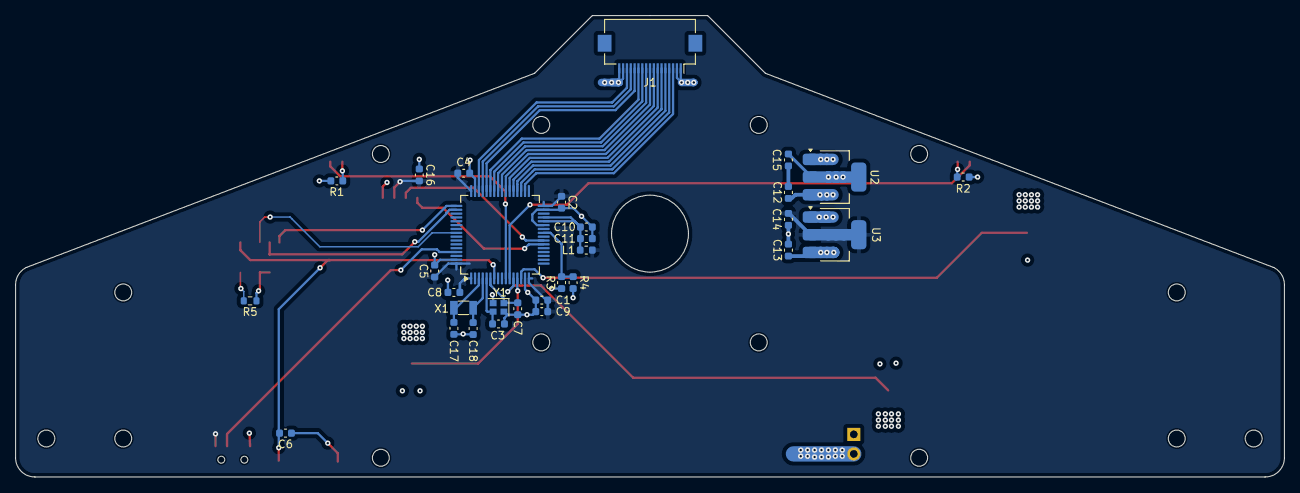
[picture p27: board photon_bldc.kicad_pcb from below]

Board: 4 copper layers, 165.0 x 60.0 mm, 37 parts (30 on the bottom side), 36 nets.

Parts:
C1: 4u7; C_0603_1608Metric
C2, C4, C5, C6, C8, C9, C11: 100n; C_0603_1608Metric
C3, C7: 6p8; C_0603_1608Metric
C10: 1u; C_0603_1608Metric
C12, C13, C14, C15: 10u; C_0603_1608Metric
C16: 0.1u; C_0603_1608Metric
C17, C18: 5p1; C_0603_1608Metric
D1, D2: LED; LED_0603_1608Metric
J1: Conn_01x17; Hirose_FH12-17S-0.5SH_1x17-1MP_P0.50mm_Horizontal
L1: 27nH; L_0603_1608Metric
PROG1: Conn_02x07_Odd_Even; PinHeader_2x07_P1.27mm_Vertical_SMD
R1, R2: 510; C_0603_1608Metric
R3: 330K; C_0603_1608Metric
R4: 200K; C_0603_1608Metric
R5: 100R; R_0603_1608Metric
RESET1: SW_SPST; SW_SPST_CK_RS282G05A3
SW1: SW_DPDT_x2; SW_SPDT_PCM12
U1: STM32G474RBTx; LQFP-64_10x10mm_P0.5mm
U2: LM1117MP-5.0; SOT-223-3_TabPin2
U3: LM1117MP-3.3; SOT-223-3_TabPin2
U4: HC-04S; hc-04
VIN1: Conn_01x02; PinSocket_1x02_P2.54mm_Vertical
X1: 32.768KHz; Crystal_SMD_3215-2Pin_3.2x1.5mm
Y1: Crystal_GND24; Crystal_SMD_2016-4Pin_2.0x1.6mm

Connections:
+3.3V: C1.1, C2.1, C4.1, C5.1, C8.1, C9.1, C14.1, C16.2, L1.1, SW1.3 (C), U1.1 (VBAT), U1.16 (VDD), U1.32 (VDD), U1.48 (VDD), U1.64 (VDD), U3.2 (VO), U4.2 (VCC)
+5V: C13.1, C15.1, J1.1, J1.2, U2.2 (VO), U3.3 (VI)
/HSE_IN: C3.1, U1.5 (PF0), Y1.3
/HSE_OUT: C7.1, U1.6 (PF1), Y1.1
/LSE_IN: C17.2, U1.3 (PC14), X1.2
/LSE_OUT: C18.2, U1.4 (PC15), X1.1
ADC: R3.2, R4.1, U1.25 (PB1)
BOOT0: SW1.2 (B), U1.61 (PB8)
GND: C1.2, C2.2, C3.2, C4.2, C5.2, C6.1, C7.2, C8.2, C9.2, C10.2, C11.2, C13.2, C14.2, C16.1, C17.1, C18.1, J1.16, J1.17, PROG1.5, PROG1.7, R1.2, R2.2, R4.2, R5.1, RESET1.1 (A), SW1.1 (A), U1.15 (VSS), U1.27 (VSSA), U1.31 (VSS), U1.47 (VSS), U1.63 (VSS), U2.1 (GND), U3.1 (GND), U4.1 (GND), VIN1.2, Y1.2, Y1.4
LED1: D2.2 (A), U1.11 (PC3)
LED2: D1.2 (A), U1.10 (PC2)
LEDON: J1.15, U1.46 (PA12)
NRST: C6.2, PROG1.12, RESET1.2 (B), U1.7 (PG10)
unnamed: C12.2, C15.2
unnamed: D1.1 (K), R1.1
unnamed: D2.1 (K), R2.1
unnamed: PROG1.11, R5.2
PC4: U1.22 (PC4), U4.4 (RXD)
PC5: U1.23 (PC5), U4.3 (TXD)
SENSOR1: J1.14, U1.45 (PA11)
SENSOR2: J1.13, U1.44 (PA10)
SENSOR3: J1.12, U1.43 (PA9)
SENSOR4: J1.11, U1.42 (PA8)
SENSOR5: J1.10, U1.41 (PC9)
SENSOR6: J1.9, U1.40 (PC8)
SENSOR7: J1.8, U1.39 (PC7)
SENSOR8: J1.7, U1.38 (PC6)
SENSOR9: J1.6, U1.37 (PB15)
SENSOR10: J1.5, U1.36 (PB14)
SENSOR11: J1.4, U1.35 (PB13)
SENSOR12: J1.3, U1.34 (PB12)
SYS_JTCK_SWCLK: PROG1.6, U1.50 (PA14)
SYS_JTDO_SWO: PROG1.8, U1.56 (PB3)
SYS_JTMS_SWDIO: PROG1.4, U1.49 (PA13)
VDC: C12.1, R3.1, U2.3 (VI), VIN1.1
VREF+: C10.1, C11.1, L1.2, U1.28 (VREF+), U1.29 (VDDA)
