awtismlover/photon-line-follower/photon_bldc/software/PhotonHardwareCofiguration/PhotonConfig/PhotonConfig.ioc

Mcu.UserName=STM32G474RETx
PA0.Signal=ADC1_IN1
PA1.Signal=ADC1_IN2
PA10.GPIO_Label=PWM_L_TIM2_CH4
PA10.Signal=S_TIM2_CH4
PA11.Signal=S_TIM4_CH1
PA12.Signal=S_TIM4_CH2
PA13.Signal=SYS_JTMS-SWDIO
PA14.Signal=SYS_JTCK-SWCLK
PA15.GPIO_Label=SPI3_CS
PA15.Signal=GPIO_Output
PA2.Signal=ADC1_IN3
PA3.Signal=ADC1_IN4
PA4.Signal=ADC2_IN17
PA5.Signal=ADC2_IN13
PA6.Signal=ADC2_IN3
PA7.Signal=ADC2_IN4
PA8.Signal=S_TIM1_CH1
PA9.Signal=S_TIM1_CH2
PB0.GPIO_Label=ADC1_IN15_Batt
PB0.Signal=ADC1_IN15
PB11.GPIO_Label=SPI2_CS2
PB11.Signal=GPIO_Output
PB12.GPIO_Label=SPI2_CS
PB12.Signal=GPIO_Output
PB13.Signal=SPI2_SCK
PB14.Signal=SPI2_MISO
PB15.Signal=SPI2_MOSI
PB4.GPIO_Label=LED4
PB4.Signal=GPIO_Output
PB5.GPIO_Label=LED3
PB5.Signal=GPIO_Output
PB6.GPIO_Label=LED2
PB6.Signal=GPIO_Output
PB7.GPIO_Label=LED1
PB7.Signal=GPIO_Output
PC0.Signal=ADC1_IN6
PC1.Signal=ADC1_IN7
PC10.Signal=SPI3_SCK
PC11.Signal=SPI3_MISO
PC12.Signal=SPI3_MOSI
PC14-OSC32_IN.Signal=RCC_OSC32_IN
PC15-OSC32_OUT.Signal=RCC_OSC32_OUT
PC2.Signal=ADC1_IN8
PC3.Signal=ADC1_IN9
PC4.Signal=USART1_TX
PC5.Signal=USART1_RX
PC8.GPIO_Label=PWM_T_TIM3_CH3
PC8.Signal=S_TIM3_CH3
PC9.GPIO_Label=PWM_R_TIM3_CH4
PC9.Signal=S_TIM3_CH4
PD2.GPIO_Label=SPI3_INT
PD2.Signal=GPXTI2
PF0-OSC_IN.Signal=RCC_OSC_IN
PF1-OSC_OUT.Signal=RCC_OSC_OUT
