awtismlover/photon-line-follower/photon_bldc/software/PhotonCode/Gruzik40LFLCode/Core/Src/motor.c

/*
 * motor.c
 *
 *  Created on: 19 gru 2024
 *      Author: Szymon Nyderek
 */

#include "main.h"
#include "motor.h"
#include "LowPassFilter.h"

/*Configuration*/
#define IMPULSES_PER_ROTATION 2000.0f
#define MEASUREMENT_PERIOD 0.001f // 0.001s 1KHZ
#define WHEEL_CIRCUMFERENCE 0.0785f
#define DIRECTION 1

void Motor_CalculateSpeed(motor_t *motor)
{
	// (0.0) --  How many impulses did we get ?
	int impulses;
	impulses = (int32_t)motor->EncoderValue - 20000;

	// (0.1) -- Invert direction to " FORWARD "
	impulses = impulses * DIRECTION;

	/*Distance traveled in 0.001s (One cycle)*/
	motor->DistanceInMeasurement = ((float)impulses * WHEEL_CIRCUMFERENCE) / (IMPULSES_PER_ROTATION);

	/*Whole distance wheel has traveled*/
	motor->DistanceTraveled = motor->DistanceTraveled + motor->DistanceInMeasurement;

	/*Get meters per second*/
	motor->MetersPerSecond = motor->DistanceInMeasurement * 1000.0f; // 1s = 1000ms

	/*Max Speed is 10m/s*/
	if((motor->MetersPerSecond > 10)&&(motor->MetersPerSecond < -10))
	{
		motor->MetersPerSecond = motor->PreviousMetersSecond;
	}
	LowPassFilter_Update(&motor->MetersPerSecondLPF, motor->MetersPerSecond);
	motor->PreviousMetersSecond = motor->MetersPerSecondLPF.output;

	motor->LpfDistanceInMeasurement = motor->MetersPerSecondLPF.output / 1000.0f;

    //How many times motor has rotated ?
	motor->NumberOfRotations = (float)impulses / 2000.0f;
	//Rotations per minute based on period and impulses
	motor->RPM = motor->NumberOfRotations * 60000.0f; //rotates per minute

	/*Max RPM is 8K*/
	if((motor->RPM > 8000) || (motor->RPM < -8000)) // |max| = 8000 Other readings are trash
	{
		motor->RPM = motor->PreviousRPM;
	}
	//Motor_SavePreviousRPMs(motor, motor->RPM);
	LowPassFilter_Update(&motor->EncoderRpmFilter, motor->RPM);
	motor->PreviousRPM = motor->EncoderRpmFilter.output;
}

void Motor_Init(motor_t *motor, float Kp, float Ki)
{
	motor->kp = Kp;
	motor->ki = Ki;
	motor->MetersPerSecondLPF.alpha = 0.1; // -- works like translation filter
}

void PI_Loop(motor_t *motor)
{
	motor->current_speed = motor->MetersPerSecondLPF.output * motor->PWM_to_MS_Scaler_value;;

	//Get absolute speed
	if(motor->current_speed < 0)
	{
		motor->current_speed = motor->current_speed * -1;
	}

	//Get the difference between speed that we need and actual speed
	motor->error =  motor->set_speed - motor->current_speed;

	//Add current error to previous errors (Max Error 1m/s)
	motor->Error_sum = motor->Error_sum + motor->error;
	if(motor->Error_sum > 10)
	{
		motor->Error_sum = 10;
	}
	else if(motor->Error_sum < -10)
	{
		motor->Error_sum = -10;
	}

	//Calculate new speed with PI parameters
	motor->speed = (motor->set_speed + (motor->error * motor->kp) + (motor->Error_sum *motor->ki));

}
