awtismlover/photon-line-follower/photon_bldc/software/PhotonCode/PhotonLFTCode/Core/Inc/dshot.h

/*
 * dshot.h
 *
 *  Created on: Jun 18, 2025
 *      Author: SNYDE
 */

#ifndef INC_DSHOT_H_
#define INC_DSHOT_H


#include "tim.h"    	// header from stm32cubemx code generate
#include <stdbool.h>
#include <math.h>		// lrintf


/* User Configuration */
// Timer Clock
#define TIMER_CLOCK				170000000	// 100MHz

// MOTOR 1 (PA3) - TIM5 Channel 4, DMA1 Stream 3 LLL
#define MOTOR_1_TIM             (&htim2)
#define MOTOR_1_TIM_CHANNEL     TIM_CHANNEL_4

// MOTOR 2 (PA2) - TIM2 Channel 3, DMA1 Stream 1 RRR
#define MOTOR_2_TIM             (&htim3)
#define MOTOR_2_TIM_CHANNEL     TIM_CHANNEL_4

// MOTOR 3 (PA0) - TIM2 Channel 1, DMA1 Stream 5 TTT
#define MOTOR_3_TIM             (&htim3)
#define MOTOR_3_TIM_CHANNEL     TIM_CHANNEL_3


/* Definition */
#define MHZ_TO_HZ(x) 			((x) * 1000000)

#define DSHOT600_HZ     		MHZ_TO_HZ(12)
#define DSHOT300_HZ     		MHZ_TO_HZ(6)
#define DSHOT150_HZ     		MHZ_TO_HZ(3)

#define MOTOR_BIT_0            	7
#define MOTOR_BIT_1            	14
#define MOTOR_BITLENGTH        	20

#define DSHOT_FRAME_SIZE       	16
#define DSHOT_DMA_BUFFER_SIZE   18 /* resolution + frame reset (2us) */

#define DSHOT_MIN_THROTTLE      48
#define DSHOT_MAX_THROTTLE     	2047
#define DSHOT_RANGE 			(DSHOT_MAX_THROTTLE - DSHOT_MIN_THROTTLE)


/* Enumeration */
typedef enum
{
    DSHOT150,
    DSHOT300,
    DSHOT600
} dshot_type_e;


/* Functions */
void dshot_init(dshot_type_e dshot_type);
void dshot_write(uint16_t* motor_value);

#endif /* INC_DSHOT_H_ */
