awtismlover/photon-line-follower/photon_bldc/software/PhotonCode/Gruzik40LFLCode/Core/Src/SimpleParser.c

/*
 * SimpleParser.c
 *
 *  Created on: Aug 28, 2024
 *      Author: Szymon
 */


#include "main.h"
#include "gpio.h"
#include "usart.h"
#include "string.h"
#include "stdio.h"
#include "RingBuffer.h"
#include "stdlib.h"
#include "SimpleParser.h"
#include "Line_Follower.h"
#include "app_fatfs.h"
char My_Name[32] = "PHOTON";

/*FatFS variables*/
extern FRESULT FatFsResult;
extern FATFS SdFatFs;
extern FIL SdCardFile;

void Parser_TakeLine(RingBuffer_t *Buf, uint8_t *ReceivedData)
{
	uint8_t Tmp;
	uint8_t i = 0;
	do
	{
		RB_Read(Buf, &Tmp);

		if(Tmp == ENDLINE)
		{
			ReceivedData[i] = 0;

		}

		else
		{
			ReceivedData[i] = Tmp;
		}
		i++;

	} while(Tmp != ENDLINE);

}
//static void EEprom_Save_Settings(LineFollower_t *LF)
//{
//	char *ParsePointer = strtok(NULL, ",");
//
//	if(strlen(ParsePointer) > 0 && strlen(ParsePointer) < 32)
//	{
//		float Mode = atof(ParsePointer);
//		/*Open Mode*/
//		uint8_t buffer[256];
//
//		if(Mode == 0)
//		{
//			/*Reset previous SLOWEST.txt and create new*/
//			FatFsResult = f_open(&SdCardFile, "SLOWEST.txt", FA_WRITE|FA_CREATE_ALWAYS);
//		}
//		else if(Mode == 1)
//		{
//			/*Reset previous SLOW.txt and create new*/
//			FatFsResult = f_open(&SdCardFile, "SLOW.txt", FA_WRITE|FA_CREATE_ALWAYS);
//		}
//		else if(Mode == 2)
//		{
//			/*Reset previous MEDIUM.txt and create new*/
//			FatFsResult = f_open(&SdCardFile, "MEDIUM.txt", FA_WRITE|FA_CREATE_ALWAYS);
//		}
//		else if(Mode == 3)
//		{
//			/*Reset previous FAST.txt and create new*/
//			FatFsResult = f_open(&SdCardFile, "FAST.txt", FA_WRITE|FA_CREATE_ALWAYS);
//		}
//		else if(Mode == 4)
//		{
//			/*Reset previous FASTEST.txt and create new*/
//			FatFsResult = f_open(&SdCardFile, "FASTEST.txt", FA_WRITE|FA_CREATE_ALWAYS);
//		}
//		if(FatFsResult == FR_OK)
//		{
//			sprintf((char*)buffer, "Turbine_speed=%0.2f,", LF->Turbine_Speed);
//			f_puts((TCHAR*)buffer, &SdCardFile);
//
//			sprintf((char*)buffer, "Treshold=%d,", LF->treshold);
//			f_puts((TCHAR*)buffer, &SdCardFile);
//
//			sprintf((char*)buffer, "kp=%0.2f,", LF->Kp);
//			f_puts((TCHAR*)buffer, &SdCardFile);
//
//			sprintf((char*)buffer, "kd=%0.2f,", LF->Kd);
//			f_puts((TCHAR*)buffer, &SdCardFile);
//
//			sprintf((char*)buffer, "Base_speed=%0.2f,", LF->Base_speed_L);
//			f_puts((TCHAR*)buffer, &SdCardFile);
//
//			sprintf((char*)buffer, "Max_speed=%0.2f,", LF->Max_speed_L);
//			f_puts((TCHAR*)buffer, &SdCardFile);
//
//			sprintf((char*)buffer, "Bend_speed_left=%0.2f,", LF->Bend_speed_left);
//			f_puts((TCHAR*)buffer, &SdCardFile);
//
//			sprintf((char*)buffer, "Bend_speed_right=%0.2f,", LF->Bend_speed_right);
//			f_puts((TCHAR*)buffer, &SdCardFile);
//
//			sprintf((char*)buffer, "Sharp_bend_speed_left=%0.2f,", LF->Sharp_bend_speed_left);
//			f_puts((TCHAR*)buffer, &SdCardFile);
//
//			sprintf((char*)buffer, "Sharp_bend_speed_right=%0.2f\n", LF->Sharp_bend_speed_right);
//			f_puts((TCHAR*)buffer, &SdCardFile);
//		}
//
//	}
//}
void Add_SimpleMap_Point(LineFollower_t *LF)
{
	char *ParsePointer = strtok(NULL, ",");

	if(strlen(ParsePointer) > 0 && strlen(ParsePointer) < 32)
	{

		 LF->ChangePoint[LF->ChangePointsCount][0] = atof(ParsePointer);

		 ParsePointer = strtok(NULL, ",");
		 LF->ChangePoint[LF->ChangePointsCount][1] = atof(ParsePointer);

		 LF->ChangePointsCount++;
	}
}
static void Sensor_treshold_change(LineFollower_t *LF)
{
	char *ParsePointer = strtok(NULL, ",");

	if(strlen(ParsePointer) > 0 && strlen(ParsePointer) < 32)
	{
		if(atof(ParsePointer) > 1500)
		{
			LF->treshold = atof(ParsePointer);
		}
	}
}
static void Turbine_Speed_change(LineFollower_t *LF)
{
	char *ParsePointer = strtok(NULL, ",");

	if(strlen(ParsePointer) > 0 && strlen(ParsePointer) < 32)
	{
		float speed = atof(ParsePointer);

		if(speed < 0)
		{
			LF->Turbine_Speed = 48 - speed;
		}
		else
		{
			LF->Turbine_Speed = 1048 + speed;
		}
	}
}
static void Turbine_Prep_Time_change(LineFollower_t *LF)
{
	char *ParsePointer = strtok(NULL, ",");

	if(strlen(ParsePointer) > 0 && strlen(ParsePointer) < 32)
	{
		LF->Turbine_Prep_Time = atof(ParsePointer);
	}
}
static void kp_change(LineFollower_t *LF)
{
	char *ParsePointer = strtok(NULL, ",");

	if(strlen(ParsePointer) > 0 && strlen(ParsePointer) < 32)
	{
		LF->Kp = atof(ParsePointer);
	}

}
static void kd_change(LineFollower_t *LF)
{
	char *ParsePointer = strtok(NULL, ",");

	if(strlen(ParsePointer) > 0 && strlen(ParsePointer) < 32)
	{
		LF->Kd = atof(ParsePointer);
	}
}
static void Base_speed_change(LineFollower_t *LF)
{
	char *ParsePointer = strtok(NULL, ",");

	if(strlen(ParsePointer) > 0 && strlen(ParsePointer) < 32)
	{
		LF->Base_speed_R = atof(ParsePointer);
		LF->Base_speed_L = atof(ParsePointer);
	}
}
static void Turbine_speed_change(LineFollower_t *LF)
{
	char *ParsePointer = strtok(NULL, ",");

	if(strlen(ParsePointer) > 0 && strlen(ParsePointer) < 32)
	{
		LF->MotorT.Speed = atof(ParsePointer);
	}
}

static void Max_speed_change(LineFollower_t *LF)
{
	char *ParsePointer = strtok(NULL, ",");

	if(strlen(ParsePointer) > 0 && strlen(ParsePointer) < 32)
	{
		LF->Max_speed_R = atof(ParsePointer);
		LF->Max_speed_L = atof(ParsePointer);
	}
}
static void Sharp_bend_speed_right_change(LineFollower_t *LF)
{
	char *ParsePointer = strtok(NULL, ",");

	if(strlen(ParsePointer) > 0 && strlen(ParsePointer) < 32)
	{
		LF->Sharp_bend_speed_right = atof(ParsePointer);
	}
}
static void Sharp_bend_speed_left_change(LineFollower_t *LF)
{
	char *ParsePointer = strtok(NULL, ",");

	if(strlen(ParsePointer) > 0 && strlen(ParsePointer) < 32)
	{
		LF->Sharp_bend_speed_left = atof(ParsePointer);
	}
}
static void Bend_speed_right_change(LineFollower_t *LF)
{
	char *ParsePointer = strtok(NULL, ",");

	if(strlen(ParsePointer) > 0 && strlen(ParsePointer) < 32)
	{
		LF->Bend_speed_right = atof(ParsePointer);
	}
}
static void Bend_speed_left_change(LineFollower_t *LF)
{
	char *ParsePointer = strtok(NULL, ",");

	if(strlen(ParsePointer) > 0 && strlen(ParsePointer) < 32)
	{
		LF->Bend_speed_left = atof(ParsePointer);
	}
}
static void App_Controll(char RxData, LineFollower_t *LineFollower)
{
	/*Stop robot*/
	if(RxData == 'N')
	{
		uint8_t buffer[124];


		/*Stop and turn off the LED*/
		LineFollower->LineFollowing = 0;
		HAL_GPIO_TogglePin(LED2_GPIO_Port, LED2_Pin);

		/*Send battery voltage*/
		LineFollower->battery_voltage = (LineFollower->Adc1_Values[4] * 8.15)/3322;
		sprintf((char*)buffer, "One Cell = %0.2f \r\n Battery_Voltage = %0.2f V \r\n AverageSpeed = %0.2f m/s \r\n MaxSpeed = %0.2f m/s \r\n", LineFollower->battery_voltage/2, LineFollower->battery_voltage, LineFollower->AverageSpeed, LineFollower->MaxSpeed);
		HAL_UART_Transmit(&huart1, buffer, strlen((char*)buffer), 100);

		/*Reset Average & Max speed*/
		LineFollower->AverageSpeed = 0;
		LineFollower->MaxSpeed = 0;
		LineFollower->AverageSpeedNum = 0;
		LineFollower->AverageSpeedSum = 0;

	}
	/*Start robot*/
	if ((RxData == 'Y')||(RxData == 'C'))
	{
		/*Proportional to battery percentage boost for motors
		 * to keep roughly same speed as with full battery*/
		float battery_percentage;
		uint8_t buffer[124];
		//Calculate battery percentage based on battery voltage
		LineFollower->battery_voltage = (LineFollower->Adc1_Values[4] * 8.15)/3322;

		//Full battery voltage in working line follower is about 8.4V
		battery_percentage = (LineFollower->battery_voltage / 8.48) * 100;

		/*To don't damage 3s LiPo battery Line follower can't start with battery below 10.6V*/
		if (LineFollower->battery_voltage < 7)
		{
			sprintf((char*)buffer, "! Low Battery !\r\n");
			HAL_UART_Transmit(&huart1, buffer, strlen((char*)buffer), 100);
			//return;
		}
		//Start the trubine
		//Turbine_Start(&LineFollower->turbine);

		/*Motor speed*/
		LineFollower->Speed_level = ((100 - battery_percentage + 100) / 100) - LineFollower->Speed_offset;

		if(LineFollower->Speed_level < 1)
		{
			LineFollower->Speed_level = 1;
		}

		/*Send battery data*/
		LineFollower->battery_voltage = (LineFollower->Adc1_Values[4] * 8.15)/3322;
		sprintf((char*)buffer, "One Cell = %0.2f \r\n Battery_Voltage = %0.2f V \r\n", LineFollower->battery_voltage/2, LineFollower->battery_voltage);
		HAL_UART_Transmit(&huart1, buffer, strlen((char*)buffer), 100);


		sprintf((char*)buffer, "Percentage = %0.2f \r\n Speed_level = %0.2f \r\n", battery_percentage, LineFollower->Speed_level);
		HAL_UART_Transmit(&huart1, buffer, strlen((char*)buffer), 100);

		/*Start LineFollower and turn on the LED*/
		LineFollower->LineFollowing = 1;
		HAL_GPIO_TogglePin(LED2_GPIO_Port, LED2_Pin);

		if(RxData == 'C')
		{
			//TODO:CYGAŃSKIE MAPOWANIE
		}
	}
}

static void Mode_change(LineFollower_t *LF)
{
	char *ParsePointer = strtok(NULL, ",");

	if(strlen(ParsePointer) > 0 && strlen(ParsePointer) < 2)
	{
		App_Controll(ParsePointer[0], LF);
	}
}
void Parser_Parse(uint8_t *ReceivedData, LineFollower_t *LineFollower)
{
	char *ParsePointer = strtok((char*)ReceivedData, "=");

	if(!strcmp("Kp",ParsePointer))
	{
		kp_change(LineFollower);
	}
	else if(!strcmp("Kd",ParsePointer))
	{
		kd_change(LineFollower);
	}
	else if(!strcmp("Base_speed",ParsePointer))
	{
		Base_speed_change(LineFollower);
	}
	else if(!strcmp("Max_speed",ParsePointer))
	{
		Max_speed_change(LineFollower);
	}
	else if(!strcmp("Sharp_bend_speed_right",ParsePointer))
	{
		Sharp_bend_speed_right_change(LineFollower);
	}
	else if(!strcmp("Sharp_bend_speed_left",ParsePointer))
	{
		Sharp_bend_speed_left_change(LineFollower);
	}
	else if(!strcmp("Bend_speed_right",ParsePointer))
	{
		Bend_speed_right_change(LineFollower);
	}
	else if(!strcmp("Bend_speed_left",ParsePointer))
	{
		Bend_speed_left_change(LineFollower);
	}
	else if(!strcmp("Turbine_speed",ParsePointer))
	{
		Turbine_speed_change(LineFollower);
	}
	else if(!strcmp("Mode",ParsePointer))
	{
		Mode_change(LineFollower);
	}
	else if(!strcmp("Treshold",ParsePointer))
	{
		Sensor_treshold_change(LineFollower);
	}
	else if(!strcmp("Turbine_Speed",ParsePointer))
	{
		Turbine_Speed_change(LineFollower);
	}
	else if(!strcmp("Turbine_Prep_Time",ParsePointer))
	{
		Turbine_Prep_Time_change(LineFollower);
	}
	else if(!strcmp("EEprom_Save_Settings",ParsePointer))
	{
		//EEprom_Save_Settings(LineFollower);
	}
	else if(!strcmp("Add_Simple_Map_Point",ParsePointer))
	{
		Add_SimpleMap_Point(LineFollower);
	}

}
void Read_Settings_From_EEprom(LineFollower_t *LF, int mode)
{
	if(mode == 0)
	{
		FatFsResult = f_open(&SdCardFile, "SLOWEST.txt", FA_READ);
	}
	else if(mode == 1)
	{
		FatFsResult = f_open(&SdCardFile, "SLOW.txt", FA_READ);
	}
	else if(mode == 2)
	{
		FatFsResult = f_open(&SdCardFile, "MEDIUM.txt", FA_READ);
	}
	else if(mode == 3)
	{
		FatFsResult = f_open(&SdCardFile, "FAST.txt", FA_READ);
	}
	else if(mode == 4)
	{
		FatFsResult = f_open(&SdCardFile, "FASTEST.txt", FA_READ);
	}
	if(FatFsResult != FR_OK)
		{
			//Send message about problem with sd card
		}
		else
		{
			// 1 is how many chars do we want to read
			//idea is to read one line we have to search for /n
			UINT len;
			uint8_t data[32];
			uint8_t sample;
			uint8_t i = 0;
			do
			{
				f_read(&SdCardFile, &sample, 1, &len);
				if(sample == '\n')
				{
					data[i] = 0;
				}
				else
				{
					data[i] = sample;
				}
				i++;
			}while(sample != '\n');


			while(1)
			{
				//TODO: pytanie czy strtok bedzie zwracał kolejne = czy cały czas jedno XD
				/*Read What we have cutted*/
				char *ParsePointer = strtok((char*)data, "=");

				if(!strcmp("Kp",ParsePointer))
				{
					kp_change(LF);
				}
				else if(!strcmp("Kd",ParsePointer))
				{
					kd_change(LF);
				}
				else if(!strcmp("Base_speed",ParsePointer))
				{
					Base_speed_change(LF);
				}
				else if(!strcmp("Max_speed",ParsePointer))
				{
					Max_speed_change(LF);
				}
				else if(!strcmp("Sharp_bend_speed_right",ParsePointer))
				{
					Sharp_bend_speed_right_change(LF);
					break;
				}
				else if(!strcmp("Sharp_bend_speed_left",ParsePointer))
				{
					Sharp_bend_speed_left_change(LF);
				}
				else if(!strcmp("Bend_speed_right",ParsePointer))
				{
					Bend_speed_right_change(LF);
				}
				else if(!strcmp("Bend_speed_left",ParsePointer))
				{
					Bend_speed_left_change(LF);
				}
				else if(!strcmp("Turbine_speed",ParsePointer))
				{
					Turbine_speed_change(LF);
				}
				else if(!strcmp("Mode",ParsePointer))
				{
					Mode_change(LF);
				}
				else if(!strcmp("Treshold",ParsePointer))
				{
					Sensor_treshold_change(LF);
				}
				else if(!strcmp("Turbine_Speed",ParsePointer))
				{
					Turbine_Speed_change(LF);
				}
			}
		}

}
