awtismlover/photon-line-follower/(commit log)

2025-03-23 Small updates to PCB
    [photon_bldc.kicad_pcb, photon_bldc.kicad_sch]
2025-04-06 begining of ESC pcb
    [ESC_PCB.kicad_pcb, ESC_PCB.kicad_sch]
2025-04-08 ESC schemat continued
    [ESC_PCB.kicad_sch, FD6288Q.step]
2025-04-09 Mosfet footprints Added
    [ESC_PCB.kicad_sch]
2025-05-07 07.05.2025r-MainPCB
    sd
    [main_board.kicad_pcb, main_board.kicad_sch]
2025-06-16 coding done v1
    [main_board.kicad_pcb]
