awtismlover/photon-line-follower/(notices)

Notices in the files:
photon_bldc/software/PhotonCode/PhotonLFTCode/Core/Src/main.c:
Copyright (c) 2025 STMicroelectronics.
All rights reserved.
This software is licensed under terms that can be found in the LICENSE file
